guido233/HoloCubic/1.Hardware/RevB-KiCad/Naive/Closure/README.md

# 本轮问题闭合状态

本轮条件是**只有文件和图纸，没有样件、板厂订单或实测数据**。已经修订能由工程文件明确解决的问题；整机装配与运行尚未闭合，不发布制造放行结论。

| 问题 | 已落实的文件和检查 | 仍缺的证据 |
| --- | --- | --- |
| 六层叠层未选择 | 选定公开 JLC06101H-3313 模板，保存请求/响应；铜与介质 1.04mm、CAD 含阻焊预算 1.06mm；机械复核已更新 | 板厂对本工程的成品厚度口径、公差、孔分类及工艺回签 |
| 显示板阻焊制造间距 | 收紧 0.10mm 阻焊桥和 0.09mm 开口到异网铜；外扩改 +0.025mm，原 33 项错误归零，铜与锡膏未以放宽规则处理 | 制造/装配方接受实际工艺 |
| 屏幕尾排纵向落点不足 | 12 个 5.5×0.50mm 长焊接区、相邻器件重排、全板重新布线；144 项相关公差计算通过 | 允许折弯半径/区段、露铜面、横向注册、焊接工艺和实际屏体就座 |
| 长焊区锡量 | 删除 LCD 全长 F.Paste，明确 PCBA 回流后手工焊接，提供 1:1 接口参考图 | 供应商/装配方对手工焊温度、搭接和外观标准的认可及样件 |
| FFC 方向不明确 | 定义八根无交叉导体、两端同面露铜、Main n↔Ext 9−n 映射与端部公差 | 最终壳内路径、允许弯曲条件、长度/完整订货号与被动夹具实测 |
| 样机替代料与共料采购 | 2026-10-30 已应用 C24 / 显示板 C4 共用 GRM188R71E105KA12D、U6 用 TPS22918DBVT、主板 R3 用 RTT022000FTH；69 位号合并为 38 个 MPN 采购行 | 实际来料与装配验收、供电波形和功能测试；尚未实测或量产放行 |
| BH1750 上电复位验收 | 明确 M10 / C11.1、M11 / C24.1 测 VCC / DVI，规定阈值区间、冷启动、慢上电及快速重插残压记录 | 对实际 C24 批次测得 VCC≥2.4V 后 DVI≤0.4V 至少 1µs；不能由 ACK 或软件等待代替 |
| 首板无明确测试入口 | 独立诊断固件已编译和检查，15 个实际元件端子测量图、记录表和具体试验步骤已提供 | 烧录及全部实物测量；含 `bh1750_dvi_reset` 的 15 项记录均 NOT_TESTED |

## 当前可交付内容

- [显示接口修订、相关公差计算和 1:1 参考图](DISPLAY-INTERFACE.md)：最小纵向搭接 0.9611mm；0.75mm 为项目手焊阈值，未冒充屏厂规范。
- [叠层与 DFM 询价定义](STACKUP-SPEC.md)：保存公开模板选中行与来源 SHA，区分订单名义、铜介质总厚和 CAD 阻焊预算。
- [FFC 定制接口定义](FFC-CABLE-SPEC.md)：已有完整电气和端部要求；长度没有数据就保留未定，不用社区 60mm 或样品料号填空。
- [诊断固件与首板验证](BRINGUP.md)、[正反面测量图](probe-map.svg)、[真实测量记录表](measurement-record.csv)。

新修订的两板原生 ERC、所有严重级别 DRC、全网连通和原理图一致性检查通过。完整检查数、故障回归及源文件散列见 [冻结记录](../VALIDATION.md) 与 [机器可读记录](../validation-results.json)。这些记录只证明所列文件约束，不证明设备已通电运行。

本次替代保持电气网络、标称容量／电阻值和接口，不要求修改固件；电容耐压和 R3 尺寸公差等变化见 [BOM 审查](../BOM-review.md)。默认 BH1750 读取 / 自动调光尚未启用，未使用的 `Ambient` helper 也不能未经计时和读取检查修正直接集成；这些现有功能边界没有被“物料替代已应用”关闭。U6 为相同芯片的包装替代，商城库存及报价仅是 2026-10-30 快照，见 [采购说明](../PURCHASING.md)。

## 继续闭合所需的最小外部输入

1. **屏厂受控图纸**：确认当前具体屏批次的尾排展开/预折状态、触点金属面、12pin pitch/露铜尺寸公差、允许折弯位置/半径、COG/元件凸高、背胶及允许焊接条件。现有 11.10±0.5mm 裸屏背折图没有这些完整定义；不能靠选一个半径继续计算成已适配。
2. **装配注册**：明确显示板/屏体相对上壳的承托面、止挡和最终姿态。历史装配缓存约 22.39° 与上壳约 29.61° 的差异仍没有唯一注册证据。取得可信装配图或样件尺寸后，才能最终锁定 FFC 路径和长度。
3. **板厂回签**：接受指定模板、实际交付总厚范围、USB 内部孔到 land 距离、细线/孔环、ENIG、指定热孔处理及阻焊图。公开能力或模板不能代替本工程的 DFM 回复。
4. **一套实际样机**：完成供电及 BH1750 VCC/DVI 复位波形、USB、屏幕/背光、SD/WiFi、传感器、温升及最终闭壳 RF 验收。现阶段没有相应读数、波形或装配照片。

因此，本轮已完成明确的文件修复和验证准备；**不能仅靠继续修改文字或运行 DRC，把上述四项标成通过**。取得资料或实物结果后，应针对同一 PCB/固件 SHA 回填记录；如需改板或改壳，重新核对所有受影响的源散列和检查结果。
