guido233/HoloCubic/1.Hardware/RevB-KiCad/Naive/MECHANICAL-REVIEW.md

# Naive RevB 机械配准与装配验收

审查日期：2026-10-29。坐标单位为 mm，采用当前 KiCad PCB 的全局 XY，X 向右、Y 向下。原 Altium PCB、STEP 和历史接口基准保持不变。

**本版本尚不能释放生产。** 本轮已用图纸定义较长的P133H002手工焊接窗口，但实际尾排弯曲、板边绕行和上壳注册尚未通过实物验证。下列二维检查和局部实体检查没有替代整机装配验证；生产前仍需完成后述验收。

## 屏幕候选与电气条件

裸屏候选为 POLCD **P133H002**，不是带排针/稳压器的转接模块。[厂家产品页](https://www.polcd-digital.com/products/1-3-inch-tft-lcd-display-240x240-pixels-p133h002)与[厂家 13 页规格书](https://cdn.shopify.com/s/files/1/0657/1150/5511/files/P133H002.pdf?v=1779866387)给出：240×240、ST7789V、12 pin、0.7 mm 间距、26.16×29.22 mm 背光外形。p9 图注明外形 ±0.2 mm，厚度 1.46±0.05 mm **不含背胶和 FPC**；不能把约 1.5 mm 当成组装后的最大厚度。

引脚顺序与原屏接口一致：1 GND，2 LEDK，3 LEDA，4 VDD，5/6 GND，7 D/C，8 CS，9 SCL，10 SDA，11 RESET，12 GND。p7 背光总电流典型 30 mA、最大 40 mA，Vf 典型 2.8 V、最大 3.2 V，p9 为两颗并联 LED，未画内置限流。p9 的“40 mA, 3.0 V”不能替代 p7 电气表的限值；寿命章节的较大电流模板文字也不能作为允许电流。

RevB AL5802 + 27 Ω 的约 24 mA 是典型设计值。AL5802 的 0.65 V 调节值没有全温区电流精度保证，不能只叠加电阻 1% 就宣称最坏电流已受控。样件必须测电源范围、环境温度和稳态封壳下的电流与温升，背光电流不得超过屏厂 40 mA 最大值。

## P133H002 图纸注册与明确长焊接窗口

当前 ExtendBoard 板框为 X **133.8072..163.1950**、Y **91.8845..118.1227**，即 29.3878×26.2382；中心 **(148.5011,105.0036)**。原始 active stack 为约 1.0 mm 介质加两侧各 0.03556 mm 铜，合计 **1.071118 mm**，不应默认采购 1.6 mm PCB。

为说明配准，假设把 P133H002 的 26.16×29.22 mm 名义玻璃/背光外形中心与板框中心重合，且尾排从板右侧折回。则名义屏外形为：

- X **133.8911..163.1111**；Y **91.9236..118.0836**。
- p9 背视图局部坐标 u 横向 0..26.16、v 纵向 0..29.22 对应：**X=133.8911+v，Y=118.0836−u**。
- p9 展开图标出前视横向 10.30、到首触点 1.85、11 个 0.7 mm 间距。换到背视后，pin 1 的 u=26.16−(10.30+1.85+7.70)=**6.31**，pin 12 的 u=**14.01**。
- 因而该居中假设下，pin n 的 Y=**111.7736−0.7×(n−1)**；pin 1 在较大 Y，pin 12 在较小 Y，整排中心 Y=**107.9236**。
- 历史 legacy LCD1 的 pin n 为 **X=156.2100，Y=111.7219−0.7×(n−1)**，中心 Y=**107.8719**。横向 pin 排配准仅差 **0.0517 mm**，说明引脚方向可以一致；这不证明尾排的纵向位置可达。

p9 的裸屏背折示意标出屏尾根至折回接触端最外沿 **11.10±0.5 mm**，露铜长度 2.00 mm。按此图的名义平面折法，接触区中心距屏尾根约 10.10 mm，映射到 **X≈153.0111**。历史焊盘中心 X=156.2100，差 **3.1989 mm**。

本轮采用显式RevB长窗口修订：每个LCD1触点为F.Cu上的 **5.5×0.5mm** land，X范围 **152.25..157.75**、中心X=155.0，pin n的Y=**111.7736−0.7×(n−1)**，整排中心Y=**107.9236**。同时修正行位置0.0517mm并保持pin1在较大Y、pin12在较小Y；原四块Altium源及其旧焊盘基准不改。F.Mask外扩每边0.025mm，**无F.Paste**，定义为装配后手工焊接裸屏尾排，不作为整面印膏回流区。图纸约束与最小搭接计算见 [显示接口记录](Closure/DISPLAY-INTERFACE.md)。

这个窗口覆盖更多名义纵向落点，不能把X≈153.0111的裸屏背折中心冒充已经认证的整板焊接中心。厂图未放入额外PCB、实际板边绕行、弯曲半径、胶带/焊点高度或回环；仍须避免拉力、锐折和焊盘桥连。较长铜面是明确工程修改，不是POLCD厂家推荐land或实物装配通过证明。

该平面示意下，11.40mm尾端宽度映射约Y **102.2236..113.6236**；从接触最外沿到屏外侧0.8mm最小突出部分，约占X **152.0111..163.9111**。这里只作为图纸参考包络。为给长落点让位，CON1和内部器件已按下面记录重排、重布线；纸上窗口及DRC通过仍不认证完整FPC折弯路径。

## LCD 分面庭院建议及其边界

LCD1 的 parent footprint 在 B.Cu，但 12 个焊盘实际均在 **F.Cu**；这是尾排焊接面，不能由 parent layer 推断焊盘也在背面。旧 tft.step 同时包含屏本体和尾排，整体 bbox 不适合作为单独的B面屏体庭院；本轮已移除该误导性3D关联。

可以独立表达两项几何，禁止把它们当成已认证整机装配模型：

| 几何 | 全局 bbox [xmin,ymin,xmax,ymax] | 含义 |
| --- | --- | --- |
| 当前 F 面 12-pad 实际铜包络 | [152.2500,103.8236,157.7500,112.0236] | 明确5.5mm手工焊接窗口，无F.Paste |
| 当前 F 面 pad 包络外扩 0.25 | [152.0000,103.5736,158.0000,112.2736] | 实际pad-only F.CrtYd，未覆盖未知FPC路径 |
| 居中 P133 名义 B 面屏体 | [133.8911,91.9236,163.1111,118.0836] | 候选屏体，不含 FPC/背胶 |
| 候选屏体外扩 0.35 | [133.5411,91.5736,163.4611,118.4336] | 含尺寸半公差 0.10 与人为装配余量 0.25；不是供应商指定庭院 |

若添加候选屏体 B.CrtYd，应在 footprint/文档显式标注 **P133 candidate / unverified assembly**，避免日后把 courtyard DRC=0 误当成屏型号已适配。

## FFC 连接器与操作区

两板 CON1 指定 **Hirose FH12-8S-0.5SH(55)**，CL0586-0744-5-55：[厂家规格与图纸入口](https://www.hirose.com/en/product/p/CL0586-0744-5-55)。8 pin、0.5 mm、bottom contact、front flip ZIF、闭合高度 2 mm、适配 0.30±0.05 mm 端部总厚度的镀金 FFC/FPC。端部接触尺寸应按厂家 FH12 catalog 的 FFC 图生产，不凭“0.5mm 8P”商品标题判断。

使用 [KiCad 官方 FH12 8pin footprint](https://github.com/KiCad/kicad-footprints/blob/master/Connector_FFC-FPC.pretty/Hirose_FH12-8S-0.5SH_1x08-1MP_P0.50mm_Horizontal.kicad_mod)。原 Altium CON1 嵌入 STEP 自称 16-position AFFC20-16-050-SHB-T，不能用它识别真实 8pin MPN或证明装配。替换焊盘及 Main 的微移应作为明确 RevB 例外记录，历史基准不覆写。

KiCad 10.0.7 随包的正确 8pin STEP 有三个闭合实体，整体 8.1×6.4×2.0 mm；5.6 mm 的 Fab 主体深度不能代表包含引脚的全部实体。Main 原位置时，正确闭合体到 U4 最大尺寸 7.1×7.1×1.04 mm body box 最小距离 **0.4532 mm**、实体交集为 0；到 U4 顶侧 pad 包络只有 **0.3032 mm**。这解释了为什么整矩形 courtyard 报碰撞，却不能据此说实际闭合塑壳必撞。

尺寸依据 [Espressif ESP32-PICO Series v1.5 第55页图13](https://www.espressif.com/sites/default/files/documentation/esp32-pico_series_datasheet_en.pdf)：D/E 最大7.100、A最大1.040 mm；7×7×0.94 mm 是名义尺寸，旧1.0 mm高度不构成最大包络。按1.04 mm重算，原CON1位置的0.4532 mm距离与零交集结果保持；最终CON1上移0.30 mm后，闭合模型到最大PICO盒的最小距离约 **0.66749 mm**。同一主板名义B面座位和更新后的1.06 mm CAD总厚下，PICO最大盒与原Upper/Lower交集为0，到Upper最小约 **2.82916 mm**；另加0.08 mm假定焊后高度预算时约 **2.74916 mm**。这项额外预算不是芯片厂家尺寸。完整计算见 [PICO高度复核](Mechanical/PICO-max-body-screening.json)，不包含FFC开盖/排线扫掠。

给 PCB agent 的 shaped courtyard 为三个独立实体投影 bbox 与全部 signal/MP 焊盘包络分别外扩 0.25 mm 后取 union，保留全部实际几何。Main CON1 上移 0.30 mm 到 **(143.9545,104.7163)** 时，与原位 U4 的对应庭院间名义约 **0.1032 mm**；U4/RF 无需因此下移。0.25 mm 是明确的密集装配设计选择，不是 Hirose 官方推荐庭院；应重新运行所有邻件 DRC。

最终邻接 C6/C10 的密集装配规则还需区别于上述初始 0.25 mm 方案。对完整 FH12 STEP 实际网格投影复核，FFC 到两颗电容最大 body 的投影距离均约 **0.2705 mm**，到铜约 **0.2915 mm**；FFC 外扩 0.25 与电容外扩 0.10 的庭院仍会重叠，不能通过删去真实几何假装保留 0.25。本轮已批准双方各 **0.10 mm** 的明确 dense margin，名义间隔约 **0.0705 mm**；该余量需装配厂接受贴装/器件公差并实测。FFC 名义模型没有替代最大制造尺寸和操作空间验收。

上述只核**闭合状态**。开盖扫掠、手指操作、排线插拔/折弯尚无完整注册模型。Ext CON1本轮向左移2.9mm，当前origin **(146.9346,105.0417)、90°**；同一正确闭合体bbox随之为X144.9346..151.3346/Y100.9917..109.0917。插入口朝较大X，出线经过LCD尾排焊接区附近，仍需实测高度及操作顺序。不能仅以二维庭院未重叠声称可插拔。

FFC端部尺寸、同面露铜、无交叉导体及定制图要求见 [排线规格](Closure/FFC-CABLE-SPEC.md)。最终长度仍依赖无拉力装配路径；标准候选不能视为已锁采购兼容性。逐线通断确认Main pin n对应Ext pin (9−n)，特别是5V/3V3/GND，再上电。两端“Type A/同向”的销售术语不能替代电气连续性检查。

## USB1 采购闭环：GCT USB4105-GF-A

RevB 选定 **GCT USB4105-GF-A**，默认 0.95 mm 穿板 shell stake，16 个电气触点、USB2.0、Top Mount。[厂家现行产品页](https://gct.co/connector/usb4105)标记 Active；[厂家当前下载图纸](https://www.gct.co/files/drawings/usb4105.pdf)实读为 **B4，18/12/2023**。原 USB1 STEP 只写 User Library-USB - C v1，不能据几何相似认定原器件也是 GCT。

使用 KiCad 10.0.7 的 `Connector_USB:USB_C_Receptacle_GCT_USB4105-xx-A_16P_TopMnt_Horizontal` 与同名正确 STEP。目标 footprint **origin (160.06617,104.9909)、90°、F.Cu**，按原模型的插入口面 X=163.74117、中心 Y=104.9909 对齐；不能沿用原 footprint origin (158.5595,104.9909)。

| 项目 | 原无型号模型/焊盘 | GCT 目标 | 差异 |
| --- | --- | --- | --- |
| 插入口外轮廓宽 | 8.95 | 8.94 | −0.01 |
| 插入口外轮廓 Z | 0.10..3.26 | 0.15..3.31 | 整体 +0.05 |
| 插入口中心 Z | 1.68 | 1.73 | +0.05 |
| 信号焊盘排 X | 156.0395 | 156.38617 | +0.34667 |
| 两定位孔 X | 157.5795 | 157.46117 | −0.11833 |
| 两定位孔 Y | 102.1009 / 107.8809 | 相同 | 0 |
| 两定位孔 | 无铜环 pad0 被导入为 PTH | Ø0.65 NPTH | GCT B4 确认塑料柱 Ø0.50、推荐孔 Ø0.65 |
| 后侧两个 shell slot X | 157.0795 | 156.96117 | −0.11833 |
| 前侧两个 shell slot X | 161.0795 | 161.14117 | +0.06167 |
| shell slot Y | 100.6659 / 109.3159 | 100.6709 / 109.3109 | 各向中心 0.005 |
| 后侧 slot 钻槽 | 1.7×0.6 | 1.7×0.6 | 不变 |
| 前侧 slot 钻槽 | 1.2×0.6 | 1.4×0.6 | 长度 +0.2 |

16 个触点对应 12 个物理信号 land；四对 VBUS/GND 各共用 land。四个 shell 脚为 SH。全部 pad、孔、slot、姿态均用明确 `naive-revb` 目标 profile 检查；不再沿用先前无型号 USB 的单独 NPTH 属性例外。历史基准保持不变。

目标 STEP bbox 为 X155.96117..163.74117、Y100.5209..109.4609、Z−0.95..3.31。源模型 bbox 为 X155.99117..163.74117、Y100.5160..109.4660、Z−1.0..3.26；向板内的实体占位仅增加约 0.03 mm。

密集装配 courtyard 采用完整 STEP 投影 bbox 与全部 pad 包络各外扩 0.25 mm 后取 union，全局 bbox [155.56117,99.9209,163.99117,110.0609]，未省略实际 body 或 land。相对 U4 原 courtyard 最右 155.3975，横向余量约 0.16367 mm。此 0.25 mm 是明确工程余量选择；默认库的 0.5 mm 矩形会多占空角，不代表实体必撞。

该变更保持插入口 XY，**Z 增高 0.05 mm**。尚无完整外壳注册，不能宣称外壳 USB 孔已通过。须核图纸公差、焊接高度、实物插头胶壳及图中 1.85 mm 最小配合间隔；保持原 face XY 不是免验收条件。

## A1 采购闭环：CA-C03 与工程焊盘

RevB 明确选用 **CrossAir CA-C03**。[原厂下载页](https://www.gzhwjdz.com/DownLoad/45858.html)取得的 CA-C03_V02 规格书 p2：L=5.5±0.2、W=2.0±0.1、T=1.0±0.1 mm，端金属长度 a=0.5±0.1 mm；白色标志侧为馈电端，另一端仅用于焊接固定。pin 1 为 RF feed，pin 2 保持 **NC，不接地**。原 Rainsun 名称与旧 STEP 不是该采购型号的依据。

保持 body center **(143.5227,115.3541)、180°、F.Cu**，使用以下 **rect 工程 pad**：

| 端点 | X 范围 | Y 范围 | 中心 | 尺寸 |
| --- | --- | --- | --- | --- |
| NC 支撑 pin2 | 140.4200..141.5227 | 114.2541..116.4541 | (140.97135,115.3541) | 1.1027×2.20 |
| RF feed pin1 | 145.5227..146.8727 | 114.2541..116.4541 | (146.1977,115.3541) | 1.3500×2.20 |

这不是直接照抄 p4 的 1.2×2.0 mm 名义参考 land：NC 外侧 toe 为板边净距裁短，两端 inward heel 与高度加大。L 最小 5.3 且 a 最大 0.6 时，左端金属内缘达到 141.4727、右端内缘达到 145.5727；加上 ±0.05 mm 端点位置误差后，分别由 heel 141.5227、145.5227 完整覆盖。最大 body 左外缘加负向贴装误差为 140.6227，仍在 NC toe 140.4200 内侧，保留约 0.2027 mm 外侧铜余量。H=2.20 覆盖 W 最大 2.10 加两侧各 0.05 误差。该 **±0.05 mm 指每个金属端任一点的位置误差，包含旋转投影**，不能只验收器件中心 ±0.05 而允许额外转角误差。

按当前真实圆弧板框计算，NC pad 的最小板边距离约 **0.2592 mm**、feed 约 **0.2970 mm**。NC toe 若取 140.4000，其下角到圆弧只有约 0.2460 mm；因此最终采用 140.4200，不能仅按矩形边缘估算。曲线离散误差上限约 0.001 mm，最后仍应以 KiCad 原生铜到板边 DRC 和制板厂尺寸公差复核。

原 RF endpoint X=146.0627、Y=115.3541 落在新 feed pad 内，七段原 RF 走线可保持；这并不代表阻抗或谐振已通过。更大 land 会改变寄生参数，装配厂必须接受该工程 land 并验收端点覆盖。参考板的 3 nH 匹配不能照搬到本板，需按最终 PCB stack、空区、外壳与显示器装配完成 VNA 匹配及实际无线性能测试。历史 A1 基准保持 advisory，只有显式 `naive-revb` profile 锁定上述 CA-C03 几何。

原 RAINSUN `123.stp` 不再用于表示 CA-C03。没有取得原厂精确 STEP 时，使用明确命名为 **Bounding Envelope** 的 5.7×2.1×1.1 mm 最大 body 包络，局部 XY 以器件中心为零、Z=0 为板面。该模型省略金属端缺口、标志和内部结构，只是保守占位示意，不是厂家精确模型，也不构成装配或 RF 验证。

## J1 采购闭环：Molex 104031-0811

RevB 选定 **Molex 104031-0811 / 1040310811**。[厂家产品页](https://www.molex.com/en-us/products/part-detail/1040310811)在浏览器实际渲染中显示 **Active**；静态网页抽取混入的隐藏“limited information”模板不能用来判定停产。[原厂正式图 SD-104031-001 B2](https://www.molex.com/content/dam/molex/molex-dot-com/products/automated/en-us/salesdrawingpdf/104/104031/1040310811_sd.pdf)与[产品规格 PS-104031-001](https://www.molex.com/content/dam/molex/molex-dot-com/products/automated/en-us/productspecificationpdf/104/104031/PS-104031-001-001.pdf)确认 push-pull、前方插入、8 个卡触点、独立常开检测开关、四个 shell solder lands、1.10 mm pitch、0.5 A/10 V。

本体名义 11.95×11.40×1.42 mm，比先前评估的 14.4×15.2 mm Amphenol GTFP08431BEU 更接近源卡座模型的约 12×11.5 mm。GTFP 大件未用于 RevB；其官网链接的 STEP 内部还标成 HR 变型，不能作为 BEU 精确模型认证。源 Micro_SD 模型同样没有确证 MPN，不把 Molex 冒充原有器件。

原模型 socket 口位 X=145.61914、完全插入卡外端 X=140.48164、卡中心轴 Y=105.4062。Molex 正式图的完全插入卡外露量为 4.0 mm，源模型约 5.1375 mm。最终为避开 USB 的贯穿固定脚及其双面焊锡铜环，采用 **origin (149.53164,105.3112)、270°、B.Cu**：

- 保留卡中心轴 **Y105.4062**；完全插入卡外端改为 **X139.83164**，比旧端左移 **0.65 mm**，不是完全保持旧端。
- 新 socket 口为 **X143.83164**，比源 socket 左移 **1.7875 mm**。
- 只保持源 socket 口时，与 USB 名义实体间距仅 0.02625 mm，等效板厚 0.9 mm 情景会交叠，因此不可用。
- 先前“完全保持卡外端”的中间位置虽有约 0.8141 mm 体距，却让 Molex 后 SH 的 B 面 copper land 与 USB 贯穿铜环实际投影重叠约 **0.2171 mm²**；同属 GND 不会产生异网短路告警，但不能作为装配通过。最终额外左移 0.65 mm 消除这一重叠。

使用完整官方 STEP 的 XY 网格投影、全部真实厂家 lands 取 union 后外扩至少 **0.25 mm**，保留全部物理几何。实际构造用 0.255 mm offset，网格弦误差 0.002 mm、轮廓简化误差 0.001 mm，以免误差吞掉所需余量。最终 shaped courtyard 有 67 个点；新 land 到 USB 贯穿铜环最小约 **0.32953 mm**，庭院到铜环约 **0.07453 mm**，所有孔/铜投影交集为 0。这是密集装配的明确工程规则，不是裁掉真几何以消除 DRC。

“等效板厚”只是 USB stake 长度/板厚风险的几何情景，不能代替真实公差分析；最终仍以所购板厚、stake 尺寸和焊接高度验收。

**正确姿态是官方 footprint 经 KiCad 原生 Flip 到 B.Cu 后设 270°。** 90° 会让卡口朝相反方向。原生 SaveBoard→LoadBoard 与全部 pad 坐标已验证：

- pin n=1..8：X=**144.08164**，Y=**102.2062+1.10×(n−1)**。
- 检测端 9=(150.23164,99.5712)，10=(153.93164,99.5712)，是独立两端常开开关；未用时按原理图明确处理，不把它们认成信号 9/10。
- SH 四个中心：(144.20664,99.7462)、(154.90664,103.0712)、(154.90664,109.0412)、(144.43164,111.0662)，全部接 GND。
- KiCad stock 的 pad8 把厂家外侧 land 裁短 0.10 mm，宽为 0.75、local X=4.545。RevB 按厂家图恢复 **0.85×1.10、local X=4.595**（翻面前的厂家坐标），保持 7×1.10=7.70 总 pitch；恢复后到 SH2 铜间距约 0.15 mm，需以本板规则和装配要求复核，不能误称 stock 与厂图完全一样。

官方产品页取得的 STEP AP242 附属 TXT 明确 REFERENCE=1040310811、SUPPLIER=Molex。模型仅做刚性坐标注册后使用，未重画或删除实体；保留原始 STEP 和转换矩阵。其卡片高度必须另读正式图：**下表面 (0.62±0.20)、上表面 (1.57±0.20) mm**，而非把 socket 的 1.42 mm 当成整个卡片装配高度。

这使源卡下方电阻列不可继续沿用。Yageo [现行 RC_L 原厂规格 V14 第 4 页](https://www.yageogroup.com/content/datasheet/asset/file/PYU-RC_GROUP_51_ROHS_L)给出 RC0402 为 1.00±0.05 × 0.50±0.05 × **0.35±0.05 mm**；0.35 不是最大高度。卡底最低参考值 0.42 mm 对 0.40 mm 最大器件高度几乎没有焊后余量。

最终17颗B电阻中，**16颗保留上部两排9+7**，R16移到下部独立位置；旧密集4×4槽及上排R16旧槽不保留。下表16颗为B面0°：

| X | y94.8 | y97.2 |
| --- | --- | --- |
| 141.7 | R4 | R1 |
| 143.7 | R5 | R13 |
| 145.7 | R12 | R18 |
| 147.7 | R7 | |
| 149.7 | R8 | R17 |
| 151.7 | R9 | R14 |
| 153.7 | R10 | R15 |
| 155.7 | R19 | R11 |
| 157.7 | R20 | |

C16 为 GRM1555C1H101JA01D（100pF / C0G / 50V / ±5%），中心 **(159.3,115.1)**、B 面、180°，厂家最大高度 0.55 mm。此型号替代早期 1nF 定时电容，并由旧上部 B 面区域移到 U6 旁；CT 铜长约 1.369 mm。外形预算不变。布尔验证按电阻最大外形 **1.05×0.55×0.40** 加 **0.08 mm 假定焊后 stand-off**，即总占位高度 **0.48 mm**；C16 最大 body **1.05×0.55×0.55** 加同样预算，合计 **0.63 mm**。0.08 是工程预算，仍需贴片工艺确认。

已对最终 Molex 配准、实际 GCT STEP 的较长固定脚/0.85 mm 等效板厚情景、卡底 0.42 至顶面 1.77 mm 包络及沿 X 抽出扫掠重新计算，18 个器件盒与这些实体交集均为 0；最终局部 CT 位置复核的最小距离为 **Molex→R16 0.8238 mm、USB→R11 3.06753 mm、卡/扫掠→R16 1.2188 mm**。PCB 上所有这些器件的庭院还须经过原生 DRC；二维无交叠不替代壳体高度检查。这只证明局部 connector/card 关系；下壳承托平台必须另作注册检查，不能由这些距离推出壳体适配。

产品规格 §7.1 建议提供防掉卡挡盖/锁卡结构，并使卡与挡盖间隙不大于 0.25 mm。Naive 旧外壳是否能提供该约束尚未验证；无实体相交不是抗冲击掉卡测试通过。最终须用所购 microSD、完整插拔和闭壳样件确定开口、接触、取卡及保卡性能。

## R16下部移位与RF投影复核

R16保留原10kΩ/0402/完整MPN和电气连接，最终为 **(144.3,112.4)、180°、B.Cu**：pin1接原**3V3**，pin2接**SD_DAT1**。它不接3V3A。SD_DAT1用B面短线接J1.8；3V3用B面支线及(142.475,111.925)的0.46/0.25mm过孔接现有In2铜岛。上部只删除原R16独占的两段3V3叶枝，公共总线三岔节点(147.8458,95.4538)及其它电阻供电保持。新DTR局部过孔/短线按原生DRC重新避让，其整网连续性恢复。

按1.05×0.55×0.40mm最大body加0.08mm假定焊后高度，R16总包络1.05×0.55×0.48mm。对实际Molex、卡片插入/抽出扫掠、USB及Upper均无交集；Molex/卡片最小体距为0.8238/1.2188mm。它与原Lower仍有约0.003598mm³交集，因此最终新下壳增加该处浅槽并移除旧上排槽，不能直接沿用旧壳。

即使原B面规则只禁铺铜，也把原Top/Bottom天线区和RF feed corridor的投影作为新R16铜的禁入区。最大body、两pad、新SD_DAT1铜、新3V3铜与该投影交集均为0，最小距离分别为 **0.3931 / 0.3481 / 0.6161 / 0.0911mm**；最后一项来自3V3支线，须明确保留，不能四舍五入成更大的设计余量。该支线到CA-C03最大body投影约1.3271mm、到完整端金属铜约1.9115mm、到原7段feed铜约2.9675mm。原7段RF几何不变；这些是几何距离，不能据此认定天线匹配、效率或最终壳体RF合格。必须在实际天线、PCB层叠、排线、屏幕和闭壳状态下做VNA及无线性能样机验收。完整最终源证据见 [R16移位筛查](Mechanical/R16-relocation-screening.json)。

## C17 正面局部移位

最终C17为 **(155.88,111.02)、90°、F.Cu**，释放 GPIO13 附近空间。按 package 最大 **1.05×0.55×0.55 mm** 加0.08 mm假定焊后高度，旋转后的全局包络为0.55×1.05×0.63 mm。对实际GCT闭合STEP、实际Molex配准和同一主板名义壳体座位计算，交集均为0；到USB、Molex、原Lower、Upper的最小体距分别约 **1.06536 / 1.24218 / 1.54416 / 3.23916 mm**。详见 [C17移位复核](Mechanical/C17-pose-screening.json)。

C17 位于F面，且与原Lower已无交集；既有22个B器件/USB穿板脚减材槽无需因此变化。0.08 mm仍是工艺预算，USB模型是闭合名义实体，不能代替器件/贴装公差、FFC操作和实物就座。对应placement profile已启用，几何记录已按最终主板重新计算并记录最终source SHA。

## 历史底面 0402 与旧 TF/卡模型检查

以下是针对**旧模型、旧位置**的历史局部检查，不作为新 Molex 卡座下方布件的依据；这些左列器件在新布局中改放上述 B 面上方空带。

使用原 PCB 嵌入的 3.stp（包含卡座与已插入 microSD 卡），对新增低矮电阻按 1.0×0.5×0.35 mm 保守盒做 OpenCascade 实体布尔及最小距：

- x143.2941，y102.93/103.82/104.71/105.60/106.49/107.38/108.27/109.16：交集均 0，最小距均约 **0.3625 mm**。
- x159.2，y100.5/101.5/102.5/103.5/104.5：交集均 0，最小距约 **1.6178..1.6935 mm**。

这些结果只证明所用 TF/卡模型与候选电阻盒的局部静态关系。底壳尚未与 PCB 做可靠注册，未核局部筋、板支撑、焊膏高度、公差或卡插拔轨迹；不能把结果当成外壳适配认证。B 面不得据此新增更高的器件。

## U4 热焊盘的明确修订

`naive-revb` 额外锁定 U4 原姿态、48 个原信号铜 land，以及 [Espressif ESP32-PICO-D4 v1.5 图 16/17](https://www.espressif.com/sites/default/files/documentation/esp32-pico-d4_datasheet_en.pdf)所依据的显式热区修订：EP 铜为 **4.5×4.5 mm**、mask margin **−0.25 mm**，得到 **4.0×4.0 mm** 开窗；pin1 角为 0.5 mm chamfer。EP 不再带整块 F.Paste，改为局部中心 ±1.575/±0.525 的 **16 个 0.75×0.75 mm paste-only pad**。

热区采用 **21 个 Ø0.46/孔 Ø0.25 mm** locked GND 通孔，5×5 格点 {−2,−1.05,0,1.05,2} 去四角，F/B tenting 标志均启用。该前面 tenting 标志不意味着 EP 的大开窗内一定能封住孔；须由制造/装配厂确认塞孔/盖油和焊膏吸锡控制。48 个 perimeter pad 的 +0.025 mm mask margin 是明确的 RevB 制造选择，不改铜和姿态。

机械检查器检查信号 land、EP 铜/层/mask/chamfer、16 个窗口及 21 个孔的尺寸/位置/层/网络/锁定/tenting，不以忽略 U4 避开基准差异。原四板历史基准及其 source SHA 保持不变。测试已验证旧尺寸 EP、整块 paste、缺失 chamfer、错误窗口、孔径/网络/tenting 和移动信号 pad 均被拒绝。此几何检查不替代回流工艺和温升验证。

## 当前 Ext 11 件静态检查

本轮最终显示板源SHA为`7ba3a6e58040c57fe67f55df174be974967f560e97ab8b37d000d93db8e1c112`，仍为11个器件、外板框不变。所有新位置与LCD长焊盘均在显式`naive-revb` Ext profile中记录；历史Altium不被覆写。原生全项DRC、未连通和原理图一致性结果由独立电气验证记录，不以此处二维配置替代。

| 器件 | 当前全局中心X/Y | KiCad角度/面 |
| --- | --- | --- |
| LCD1 | 150.9522 / 104.5591 | −90° / B（pads在F） |
| CON1 | 146.9346 / 105.0417 | 90° / F |
| C1 | 142.8 / 107.2 | 0° / F |
| C2 | 141.5 / 105.5 | 0° / F |
| C3 | 138.5 / 108.5 | 0° / F |
| C4 | 138.2 / 106.5 | 0° / F |
| Q1 | 150.0952 / 112.9665 | −90° / F |
| R1 | 147.6822 / 112.6871 | 90° / F |
| R2 | 144.5 / 115.1 | 90° / F |
| R3 | 147.2 / 115.0 | 0° / F |
| U1 | 141.0 / 112.2 | 0° / F |

LCD1为B面parent、F面焊接触点，不能按parent猜焊接面。F面长窗口庭院与候选B面屏体庭院分开，`MechanicalStatus`仍标记装配未验证。新profile负例拒绝旧2.032mm焊盘窗口、旧CON1位置、恢复LCD印膏层和LCD阻焊外扩回到0.05mm；其余F件位置也被锁定。新版庭院间距及原生结果见 [显示接口记录](Closure/DISPLAY-INTERFACE.md)。内部器件重排不提供上壳或排线的唯一刚体注册，完整高度和操作验收仍按后文边界执行。

Q1 已改为 **AO3400A N-MOS，pin1 G / pin2 S / pin3 D**，避免 NPN 基极网络加载 GPIO5 启动 strap。AOS [产品页](https://www.aosmd.com/products/mosfets/low-voltage-mosfets-12v-30v/ao3400a)链接的 [SOT23 正式图 PO-00001N](https://www.aosmd.com/sites/default/files/res/package/SOT23.pdf)给出总高 **1.25 mm MAX**，不能套用其他厂商 SOT23 的 1.12 mm。body D 2.8..3.1、E1 1.4..1.8、lead span E 2.6..3.0，推荐 land 为 0.8×0.8 mm、两列中心 2.4 mm、同列 pitch 0.95 mm。已独立实读 `SOT23_NMOS` 三个焊盘：local 1(−1.2,−0.95)、2(−1.2,+0.95)、3(+1.2,0)，尺寸均 0.8×0.8 mm，符合该推荐图；不是沿用 Diodes NPN 的焊盘。

AL5802 SOT26 最大总高度约 1.4 mm；AO3400A 1.25 mm；Hirose 2 mm；新增电容/电阻实际高度需依最终 BOM 封装型号确认。屏背胶/FPC/焊点的 0.45 mm MAX 局部高度不能自动视为整机余量。没有可靠板间距、外壳注册与开盖模型，因此没有完成封壳实体布尔或整机高度认证。

## Main六层工程叠层与检查规则

最终Main选择 **F.Cu / In1.Cu / In2.Cu / In3.Cu / In4.Cu / B.Cu**，选用公开 **JLC06101H-3313** 模板，CAD含双面各0.01mm阻焊预算的总厚为 **1.06mm**。自上而下mm：mask0.010 / F铜0.035 / prepreg0.0994 / In1铜0.0152 / core0.250 / In2铜0.0152 / prepreg0.2104 / In3铜0.0152 / core0.250 / In4铜0.0152 / prepreg0.0994 / B铜0.035 / mask0.010。

[制造叠层记录](Closure/STACKUP-SPEC.md)保存官方公开接口、选中模板和原始响应：铜与介质合计1.04mm，双面阻焊各0.01mm为CAD工程预算。**订单名义1.0mm、模板compressionThickness=1.04mm、CAD1.06mm口径不同**，不能互相替代。Dk采用官方设计值3313=4.1、7628=4.4、core=4.6；未取得批次/频率/Df或本订单回签，不据此宣称控阻抗/RF合格。实际下单仍需板厂确认材料、成品厚度范围、阻焊及装配工艺。

In1和In4为专用GND，In2混合3V3/其它电源与信号，In3为信号和GND铺铜。三条原天线/馈线keepout完整扩展至全部四个内层，tracks/vias/pads/copperpour均禁用，外层原7段RF保持。`naive-revb` profile核层序、逐层厚度、In1/In4整板GND zone意图及禁止异网走线/铜区，并以0.001mm几何容差区分三条相近keepout；同时锁定16颗上部B电阻、下部R16/C16、C17及已批准内部器件位置。

本次仅中央prepreg从0.1696改为0.2104mm、CAD总厚从1.0192改为1.06mm，增加0.0408mm；材料/Dk元数据同步公开模板。已逐项比较58封装、1033直线、4弧线、145过孔、32铜区及板框图形AST，全部相同。B面承托不变，F面PICO/L1/C17/USB与闭合FFC相对壳体整体上移0.0408mm；PICO/L1/C17按新总厚直接重算，B面R16及RF的XY距离用不变几何证明转移。下壳仍从原Lower重建，22包络、切削参数和STEP DATA与旧版相同，仅报告与STEP头更新。

历史四块Altium的两层源、SHA和几何均未改写；显示板保留两层。六层负例覆盖回退两/四层、core/总厚错误、keepout删除/放松、缺任一专用地平面、在In1/In4走异网信号及旧R16位置，均应被拒绝。整体旋转37°仍通过。几何profile不替代原生重铺铜/孤岛/网络连续性检查、实际制造叠层确认和RF实测。

## 原 Naive 下壳注册与 RevB 内侧避让

已读取原 `4.3D Model/Naive Version/Lower.step` / `Upper.step`，不是按外包围盒居中。主板有独特非矩形舌部和多个不同半径的圆角，下壳对应凹口可提供名义注册：

- 下壳长侧壁 case X=+11.7475003745 / −11.7474998687 分别对应 PCB Y116.7511 / 93.2561。
- 舌端 case Y=−12.0680578747 与 USB 侧板端 case Y=16.4309426150，独立对应 PCB X134.2517 / 162.7505。采用平均平移，两端残差约 ±0.0001003 mm。
- 独特圆角半径 0.43360565 / 0.82794711 与对应板框约 0.433629 / 0.827940 及周边平面一致；USB mating face 映射到 case Y17.421512，也与壳内端面约 17.42094 对应。

以 PCB 全局 XY 和 **Z 向 B 面外侧**为输入，名义变换为：

```text
case X = PCB Y − 105.0035997471
case Y = PCB X − 146.3196576298
case Z = 3.0708410413 − Z
```

Z=3.0708410413 是与该非矩形 PCB 凹口相连的水平承托平台。这里明确假定 PCB B 面在该平台就座，而不是从同中心或 MCU 高度猜测。该**名义承托注册仍需实物确认**；PCB 翘曲、打印收缩、承托间隙和固定预载尚未测量。源 MbaDoc 没有壳体或 mate，不能宣称存在原作者显式整机定位约束。

同一注册下，原壳与16颗上部电阻高度预算盒分别交叠约0.2772mm³，新R16约0.003598mm³，最终局部C16约0.363825mm³，说明新增 B 面器件不能直接配旧下壳。Molex、插入卡包络、GCT、Main 的闭合 FH12 及电感保守盒与原上下壳局部交集均为 0；这不覆盖显示板和排线操作。L1 厂家最大package为 **3.1×3.1×1.2 mm**；这里采用的 **3.4×3.1×1.28 mm** 盒在X另留0.30 mm、在高度另计0.08 mm假定焊后预算，是额外工程筛查包络，不是厂家标称body。以当前L1中心(146.25,95.95)、1.06 mm CAD主板总厚重新计算，厂家最大盒和该额外包络到Upper最小距离分别约 **2.66916/2.58916 mm**，与原上下壳交集均为0。

因此新增 [Lower-RevB.step](Mechanical/Lower-RevB.step)，只对下壳内侧减材，原 Lower.step SHA256 为 `23b730990a614816d785743643510fa44fa6864c99214521034c588333707fc2`，原壳文件不改。避让槽先取**最大 body 与当前焊盘落锡包络的 union**，再加 XY 各 0.25 mm、Z 0.15 mm；不会只给塑壳让位而压住向外伸出的焊盘焊锡。电阻槽深 0.63 mm，最终 (159.3,115.1) 的 C16 槽深 0.78 mm；不保留旧 (149.22,98.04) 的槽；另有下述 USB SH 内侧浅槽。板的承托高度、外轮廓、USB 孔和螺柱保持。

[机器验证记录](Mechanical/Lower-RevB-verification.json)保存原 CAD SHA、OCP 版本、脚本/参数 SHA、输入/输出体积与 bbox、solid/valid 和 STEP 重读结果。18 个器件及 4 个 USB 穿板/落锡包络与输出 STEP 的交集均为 0，最小实体距离约 **0.1500 mm**。新增槽底至外底至少 **2.29084 mm**、新槽到外侧壁至少 **2.72640 mm**、到四个 Ø4 紧固沉孔的 R2 保留区至少 **1.00966 mm**（最近处是局部 C16 槽）。R2按模型最大的Ø4沉孔包络取保护区，不是由模型认证另一种螺柱外径。原 TF 凹腔已有的 **1.0 mm** 底壁不变；2.29084 不是全壳最薄处的宣称。

输出仍为一个 valid solid，外 bbox 不变；STEP 重读仅有约 0.000280 mm³ 的体积数值差（小于 1 ppm），并重新检查 bbox 与所有器件间距。该微小差异作为 STEP 数值容差记录，不以体积相近替代实体距离检查。

可在独立 Python 3.11+ 虚拟环境安装 `cadquery-ocp==8.0.1.1.0`，在仓库根运行：

```sh
python tools/hardware/revb_case.py --output /tmp/Naive-RevB-Mechanical
```

输出目录必须不存在。脚本核原壳 SHA、当前 Main 接口/热区 profile、18 个器件位置、实际焊盘包络及 4 个 USB SH 位置后重新减材；尺寸或位置变化会停止，不能自动把未审的新布局当成已验证。

卡片完全插入时不碰壳，但往外抽出的扫掠与旧下壳前墙相交。此壳没有可供该轨迹通过的外部 SD slot，因此**必须拆下壳换卡**；RevB 仅增加内部浅槽，没有承诺闭壳取卡。需要外部换卡时，须另行设计壳口和保卡结构。

## USB 对成品板厚的敏感性与穿板脚避让

GCT B4 图给出默认 stake **S=0.95±0.15 mm**，不是精确 0.95。成品板厚 0.90 mm、最大 stake 1.10 mm 时，金属最多可伸出 B 面约 **0.20 mm**；先前只用名义 0.95 与等效 0.85 板的场景只覆盖约 0.10 mm 穿出量。

对成品厚 **0.90 / 1.00 / 1.09112 / 1.10 mm**、0 / 0.08 mm 假定焊接 stand-off、整个 USB 模型 Z 偏移 −0.15 / 0 / +0.15 mm 作 **24 个离散情景**筛查。整模偏移只是保守筛查手段，不是每个表面独立公差的严格 GD&T 模型。Molex 与 USB 全部交集为0、最小体距约 **1.10504 mm**；上壳全部交集为0、最小体距约 **0.28916 mm**。

较薄板场景中，GCT 前侧两根 stake 会穿入原承托平台。最坏相交仅位于 case X[−4.4827,−4.1827]/[4.1573,4.4573]、Y14.5060..15.1370、Z2.87084..3.07084；没有因此要求移动外部 USB 开口。

最终下壳对四个 SH 位置统一按**整片铜环/slot 投影外加0.25 mm**开内部避让：0.20 mm 金属穿出 + **0.15 mm 假定焊锡高度预算** + 0.15 mm Z 净空，槽深 **0.50 mm**。前两槽实际减材，后两处原 TF 低腔已提供空间。此处焊锡预算与 SMD 的0.08 mm stand-off预算用途不同，均须由装配工艺确认。新槽底2.57084 mm仍高于 C16 避让槽底2.29084 mm，不改变总体最小新槽底预算。

[厚度筛查记录](Mechanical/USB-thickness-screening.json)保留24个参数情景的既有直接CAD结果，并用最终R16变更的材料集合证明转移至当前STEP：其它21个cut box和原Lower完全相同，新增回填材料仅可能位于旧R16顶槽（globalY≤97.77），USB的globalY≥100.5209，间隔至少2.7509mm；新增R16下槽是减材，其区域又与USB在X上至少相隔10.63117mm。两处均远于旧情景的最近距离，故全部交集与最小距保持。最终STEP先前直接复核的最薄/旧名义1.0192/最高三项仍按原参数保留，均为0交集；下壳距离约0.20857/0.47777/0.50490mm。另新增当前**1.06mm**下0/0.08mm焊后预算、−0.15/0/+0.15mm整模Z偏移的6项直接检查；所有上下壳/Molex交集为0。当前1.06、零额外偏移场景下，下壳/Upper/Molex最小距为0.50490/0.55916/1.35345mm。旧24项及旧名义没有被改名成新厚度。该转移证明没有冒充24次新的直接运算，也没有把离散筛查称为完整GD&T或插头胶壳认证。原承托名义Z、实际成品板厚、焊锡堆高和插头胶壳仍须样件验收。

## 显示板与上壳尚未建立唯一注册

重新解包原 MbaDoc 只有两块 PCB 缓存，`MatingPairs=[]`，没有壳体。缓存 ExtendBoard 相对主板倾斜约 **22.39281°**，而 Upper.step 最大倾斜平面约 **29.61254°**，相差约 7.22°；不能直接拿缓存变换给上壳配准。

上壳该倾斜面的外矩形约 27×30 mm，显示板外形 26.2382×29.3878 mm 仅提示几何相近。居中后约 0.3809/0.3061 mm 的余量不能选定真实承托面、沿斜面平移、板的正反面或槽内高度。显示板无定位孔，也未找到能独立确定这些自由度的匹配阶差/止挡组合；用任意居中变换做布尔会给出不可靠的“通过”。

该斜面的一个参数化候选可写为：令 u=PCB_X−148.5011、v=PCB_Y−105.0036，则 C=(0,3.652841,26.664389)+v·(1,0,0)+u·(0,0.86938681,−0.49413214)+δ·(0,−0.49413214,−0.86938681)。其中 δ 是未定承托偏移，还存在沿面平移及 u/v 反向的选择；此式仅表达现有面法向约束，没有被用作通过判断。

因此尚未给 Ext 的 FH12、SOT26、AO3400A、候选 LCD/FPC 以及两板间排线出具上壳配合认证。需实测显示板承托面/止挡、板间高度、屏背胶与 FPC 绕行后，记录其刚体变换再补完整检查。新增下壳的主板局部通过不能替代这一门槛。

## 外购物料与紧固件的证据边界

原作者 README 指定一个 **25.4×25.4×25.4 mm 分光立方体**及少量 **OCA 固态光学胶膜**。作者在 [issue58](https://github.com/peng-zhihui/HoloCubic/issues/58#issuecomment-980536929)澄清购买的是分光棱镜；没有给出确切镀膜、分光比、NPBS/PBS、玻璃或完整光学料号。1:1 商品描述来自社区回复，不应改写成作者指定规格。OCA 厚度也未锁，须连同屏/FPC 样件确定；先测试偏振方向和成像，再固定。

上下壳使用原 Upper.step 与新增 Lower-RevB.step。四个螺钉轴中心在 case (±9,−9)、(±10,17)。下壳有 **Ø4 mm、深3 mm** 的沉孔和 **Ø2.5 mm、长5 mm** 的通孔；上壳为 **Ø1.5 mm、深5 mm** 的盲孔。模型可证明数量为4和上述孔尺寸，未定义螺纹。

头径小于4 mm、头高小于3 mm、头下长约8 mm 的 M2 级螺钉可作为试装候选：穿下壳5 mm后在上壳啮入约3 mm。但 Ø1.5 盲孔不能单独确证标准机牙或自攻牙，完整牙型/长度必须由打印或加工方按材料和试装锁定。该候选不作为已经验证的最终紧固件 MPN；也不据此盲拧树脂件。

## 释放生产前必须完成的样件验收

1. 供应商确认 P133H002 的确切图纸版本、供货时尾排展开/预折状态、接触露铜面、允许折弯位置/半径，以及两颗 LED 的总电流上限；取得同批裸屏样件。
2. 用最终 1.0 mm finished-thickness 约定的 PCB/等厚机械样片、实际屏/背胶和外壳，确定无拉力、无锐折的尾排绕行路径。测量 12 个触点对当前焊盘的真实注册，确认最小焊接重叠、无桥连、无板边切割 FPC。若不能满足，修订 LCD 焊盘和周围器件，更新明确机械 profile，再重做电气/DRC 检查。
3. 核实 FH12 开盖、插入、锁闭和更换均可操作；排线接触面/端厚/宽度符合官方图，安装后没有压迫屏尾排、器件或壳筋。固定电缆两端后仍留有余量，通断和电源映射正确。
4. USB1 已锁 GCT USB4105-GF-A，按前述新 footprint 与官方图核实定位孔、插入口高度和实物插头操作；A1 已锁 CA-C03 并须验收上述工程 land；J1 已锁 Molex 104031-0811，验证完全插入卡的位置、整个插拔轨迹和挡盖/保卡约束。
5. 装入 microSD 并核其拔插；使用新增 RevB 下壳，实测主板在承托面就座及 17 颗 B 面电阻、C16 的避让，包含上述 0.48/0.63 mm 焊后高度预算；核 2 mm FFC、1.4 mm SOT26、最高电容/电感与上部件高度。
6. 完整闭合外壳，测试屏幕刷新、背光最坏电流/稳态温升、USB 接口和无线连接。CA-C03 需核净空、匹配并实测，已锁型号不等于匹配完成。最后重跑原理图一致性、铜皮重铺、ERC/DRC及机械接口检查，保存验收证据。

局部 CAD 结果与样件验收应分别记录。尚无某项检查的结果时，不以“DRC 全零”或旧 3D 模型代替该项通过结论。

## 2026-10-30 物料替代的适用性

本轮应用主板 C24、扩展板 C4、U6 和主板 R3 的新料号，完整原厂身份及替代前后文件 SHA 见 [物料变更记录](component-substitutions.json)。两板全部非物料字段的原生结构、网络、布线、焊盘、位姿、层叠及模型逐项保持。两处电容的最大本体均保持 0.9mm，U6 为相同 DBV6；R3 候选最大 1.10×0.55×0.35mm，在原庭院内，现有密集 land 的贴装工艺仍需首板确认。

本目录五份 Mechanical JSON 保留原数值计算和原始输入散列，新增 component_substitution_transfer 指向当前 PCB 与本次几何保持证据，没有把原计算改写成新 STEP 布尔计算或实物试装。本轮板框/孔/接口修订检查重新通过；完整显示装配、屏幕尾排和壳体公差的实物验收条件保持。
