guido233/HoloCubic/1.Hardware/RevB-KiCad/Naive/Closure/DISPLAY-INTERFACE.md

# 显示屏纵向焊接落点修订

本次实际修改显示板，关闭的是**接触端沿 X 方向的落点范围不足**。P133H002 尾排的允许弯折半径、露铜面、横向注册及完整装配仍待供应商或样品确认，不能把本项计算改写为整机已适配。

## 原厂尺寸与计算边界

依据 [POLCD P133H002 原厂规格书](https://cdn.shopify.com/s/files/1/0657/1150/5511/files/P133H002.pdf?v=1779866387) 第 9 页 Rev A 机械图（图页标注 2021.10.7，原始图日期 2020.09.10）：屏体长 29.22±0.2mm；裸屏背折示意的 11.10±0.5mm 是尾根到**露铜端外沿**，并非接触中心。露铜长度 2.00mm 采用图中 NOTE9 未注尺寸 ±0.2mm。FPC 以展开状态出货；图未给允许折弯半径或区段。

名义屏体与 PCB 中心重合时，尾根 X=163.1111mm。计入居中屏体半长偏差后，尾根范围为 [163.0111,163.2111]mm。令尾根为 R，背折外沿尺寸为 D，露铜长度为 L，则露铜区间为 **[R−D, R−D+L]**。这些相关量一起枚举，不能先给接触中心一个 ±0.5mm，再把露铜长度独立固定为 2mm。

## 已实施的工程变更

- 12 个 F 面焊盘改为 **5.5×0.50mm、0.70mm 间距**；X 区间统一为 **[152.25,157.75]mm**，pin n 的 Y=111.7736−0.7×(n−1)mm。引脚功能、顺序及电源映射不变。
- F 面焊接庭院完整包络 [152.0,103.5736,158.0,112.2736]mm，包含每侧 0.25mm 余量。B 面候选屏体庭院保留，仍不代表完整尾排几何。
- 为让开真实铜和庭院，调整 CON1、Q1、R1、C1、R2、R3 并重新布线；没有裁掉相邻器件真实庭院。显示板板框保持不变。
- 所有 SMD 阻焊扩张改为 +0.025mm，项目检查绿色阻焊桥至少 0.10mm、开窗到异网铜至少 0.09mm。新 LCD 相邻焊盘名义铜间距 0.20mm、阻焊桥 0.15mm。
- 长焊盘**不生成 F.Paste 开口**。屏幕尾排须在 PCB 元件回流完成后，用受控上锡和助焊剂手工焊接；不可按整条 5.5mm 焊盘开生产钢网或把裸屏一起回流。仍须检查全部 12 触点、桥连和焊接温度工艺。
- 删除原来包含未知尾排路径的旧整屏 3D 模型，避免用旧模型冒充新接口已经适配。

## 计算与原生检查结果

以两端屏长、两端 11.10±0.5mm、两端 2.00±0.2mm 组成 8 个角点，对全部 12 个焊盘计算纵向搭接；最小为 **0.9611mm**。另外用旧位置中心 156.21±0.5mm 和两端露铜长度做 4 个敏感性情景，最小搭接 1.8mm。共 **12×(8+4)=144 项**，全部满足项目选定的 0.75mm 最小纵向搭接。

**0.75mm 是本项目手工焊接的工程验收阈值，不是 POLCD 批准的焊接规范。** 旧位置情景是接口容差敏感性分析，不是实际弯折路径证据。通过纵向搭接也不能证明尾排在不受拉、不断铜的条件下能到达这里。

修订后的原生 KiCad 10 检查结果：所有严重级别 DRC=0、未连接=0、原理图一致性问题=0，ERC=0；本地 8 个封装库匹配。实际源 SHA 及每个焊盘坐标见 [计算记录](P133H002-interface-closure.json)。

## 复现和装配参考

在仓库根目录执行，仅使用 Python 标准库及同目录的工程解析模块，不修改 PCB、原理图或应用：

```sh
python3 tools/hardware/display_interface_allowance.py --output-dir /tmp/naive-display-interface
```

输出目录须为新目录或空目录。脚本读取当前显示板，核对 12 个焊盘尺寸、F.Cu/F.Mask、无 F.Paste、间距，并重生 JSON 和 [1:1 接口参考图](P133H002-interface-guide-1to1.svg)。图为 148×105mm，打印选择 100%，先量 **20mm 校准标尺**；它是装配基准图，不是钢网、生产光绘或已经试装的证明。

仍须确认 12pin 的横向对齐、露铜面与朝向、允许折弯区段/半径、背胶和焊点厚度、屏板承托及闭壳后的排线路径。没有这些资料时，不继续加宽 Y 向焊盘来掩盖不确定性，也不宣称屏幕机械接口全部闭合。
