guido233/HoloCubic/1.Hardware/RevB-KiCad/Naive/Closure/FFC-CABLE-SPEC.md

# Naive RevB 板间 FFC 接口定义 R1

本文件把电源/信号映射、裸铜接触面和端部尺寸变成可检查的要求。**当前没有样件，也没有唯一的显示板装配坐标，因此不发布排线长度或制造放行结论。** 机器可读定义、当前两块 PCB 的 SHA 及来源见 [ffc-interface.json](ffc-interface.json)。本文件不改变 PCB、原理图或既有 BOM。

## 1. 接头与逐线映射

两端均为 Hirose **FH12-8S-0.5SH(55)**，HRS 编号 CL0586-0744-5-55，8 位、0.5mm、底接触。插入后两端的裸铜/镀金接触面均须朝向各自 PCB。连接器本地引脚顺序和出线方向由实际受控封装确定，不能按屏幕朝向猜测。

| 主板 CON1 | 显示板 CON1 | 功能 |
| ---: | ---: | --- |
| 1 | 8 | GPIO5 / LCD_BL |
| 2 | 7 | GPIO4 / RES |
| 3 | 6 | GPIO23 / MOSI |
| 4 | 5 | GPIO18 / SCK |
| 5 | 4 | GPIO2 / D/C |
| 6 | 3 | GND |
| 7 | 2 | 3V3 |
| 8 | 1 | VDD_5V，负载开关后的 5V |

这张表来自最终原生 PCB 网名，兼容检查应逐项比较，不用“同向线/反向线”商品名称替代。连接器的 0.5A 额定不是全板电源保证；Hirose 对全部触点同时载流给出 70% 降额，实际负载还须结合温升预算验收。

来源：[Hirose 单品规格](https://www.hirose.com/en/product/p/CL0586-0744-5-55)、[FH12 系列目录](https://www.hirose.com/en/product/series/FH12/documents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)第 2、10、15-16 页。

## 2. 接触面方向的推导

采用八根平行、无交叉导体的普通 FFC，**摊平后两端接触露铜位于同一材料面**。Molex 对此称 Type A；供应商字母命名可以不同，采购图必须画出两个露铜面。该选型与两板都使用同一底接触接头共同实现 Main n 对 Ext 9-n。

这不是仅凭商品标题得出的判断。在每个接头定义：d 为排线从接头向外的方向，w 为 pin1 指向 pin8 的方向，n 为 PCB 正面法向。两端相同受控接头的局部关系均为 `d × w = -n`。连续线缆沿 A 端向外、沿 B 端向内；两端采用相同材料接触面时，导体编号轴在 A 与 w 同向、在 B 与 w 反向，因此接头编号倒序。两板整体旋转或倾斜不改变该局部编号关系，但会改变排线能否在壳内布置。

两端露铜位于不同材料面的无交叉排线会形成 Main n 对 Ext n，**不符合本电路**。例如主板 MOSI 会对到显示板 GND。不得靠强折排线或倒插接触面来尝试纠正。若使用交叉 FPC、转接板或不同接触手性的连接器，本推导不适用，必须重新给出整条映射。

Molex Type A / D 的面定义见其 [PS-15020-001 Rev F](https://www.molex.com/content/dam/molex/molex-dot-com/products/automated/en-us/productspecificationpdf/150/15020/PS-15020-001-001.pdf)第 3 页。此处电路映射是对当前两端实际封装的工程推导，仍须用被动夹具实测 8×8 导通矩阵确认成品。

## 3. 定制排线端部要求

内部图纸编号 **HC-N-FFC-08P05-SS-LVAR-R1**，不是供应商完整订货号。下表同时约束两个端部，单位 mm。数量、尺寸及相互位置应放在同一受控加工图中，不能逐项独立取极限而破坏整体几何。

| 项目 | 定制图要求 | 依据 |
| --- | ---: | --- |
| 导体数量 | 8 | 当前两板接口 |
| 相邻中心距 | 0.50 ±0.05 | Hirose FH12 推荐端部图 |
| 首末导体中心跨度 | 3.50 ±0.05 | 8 位 FH12 图的 A 尺寸 |
| 总宽 | 4.50 ±0.07 | 8 位 FH12 图的 B 尺寸 |
| 导体宽 | 0.30 ±0.03 | Hirose 的 FFC 项，不能误用 FPC 宽度项 |
| 边缘到最外导体中心 | 0.50 ±0.10 | Hirose 推荐端部图 |
| 插入区总厚度 | 0.30 ±0.05 | Hirose 适用端厚 |
| 补强片本身厚度 | 至少 0.188 | Hirose FPC/FFC 构造注释；须同时满足插入区总厚，不能简单额外叠加 |
| 裸铜接触长度 | 4.00 ±0.25 | 工程收紧，最小 3.75，覆盖 FH12 图的 3.5 最小要求 |
| 端部补强长度 | 6.00 ±0.50 | 工程收紧，最小 5.50，覆盖 FH12 图的 4.5 最小要求 |
| 接触表面 | 镀金 | Hirose 适配接触材料要求 |
| 摊平后的露铜面 | 两端同面 | 第 2 节的无交叉导体映射 |
| 总长 L | **未定，不可填默认 60mm** | 第 4 节装配输入不足 |

端部总厚度合格不能代替补强、绝缘层和导体构成的适配确认。供应商须按 FH12 目录对应的 FFC 构造图确认层材与补强，提交有公差的加工图。上表中收紧的裸铜和补强长度是本项目工程要求，不冒充厂家既有产品规格。

图形归属另用 [DigiKey 留存的 Hirose 原厂目录](https://media.digikey.com/pdf/Data%20Sheets/Hirose%20PDFs/FH12_Series.pdf)第 11 页直接渲染复核：3.5MIN 对应接触露铜，4.5MIN 对应背面补强长度，8 位 A=3.5/B=4.5，以及 FFC 与 FPC 的导体宽度项分别列出。该存档 PDF 创建于 2014 年，不冒充当前官网版本；当前官网目录第 10 页的同名尺寸已文本交叉核对，生产前仍须供应商按当前受控图确认。核对散列见 [图形复核记录](ffc-endpoint-visual-review.json)。

## 4. 长度与壳内路径

当前显示板与上壳尚未建立唯一的装配变换，两个历史倾角也不一致。因此不能从两个 PCB 的各自 XY 坐标直接算出板间距离，不能把社区约 60mm 当作最终长度。

待锁定输入包括：两板刚体装配变换、成品板厚、连接器实际插入止挡/出线方向、LCD 与尾排包络、连接器开盖扫掠、壳筋、装配顺序、供应商允许的静态弯曲半径及补强区禁弯长度。

统一按两端切口的 tip-to-tip 长度定义：

`L = A端插入长度 + B端插入长度 + Σ直线段 + Σ(中性层弯曲半径 × 弯曲角弧度) + 装配余量`

插入长度必须取接头图纸/实际止挡，不把裸铜长度当插入长度。余量是明确的可容纳服务弯，不是任意多出的线长；还需验证最长公差的排线不会顶压器件或壳体、最短公差的排线不受拉力。

Molex 规格中的 3mm 直径冷绕试验、手动折叠试验和 R=10mm 寿命试验是各自测试条件，**没有直接给出本装配允许的最小永久弯曲半径**，不得任取其中一个数作为整机放行依据。

## 5. 已查到的完整料号：仅供有条件取样

以下原厂单品身份明确，均为 8 位、0.5mm、镀金、摊平后露铜同面，电气布局类型符合第 2 节：

| 厂家料号 | tip-to-tip 名义长度 | 总长公差 | 两端补强之间的长度范围 | 状态 |
| --- | ---: | ---: | ---: | --- |
| [Molex 15020-0075](https://www.molex.com/en-us/products/part-detail/150200075) | 51 | ±2 | 35..43 | 有条件样品候选 |
| [Molex 15020-0077](https://www.molex.com/en-us/products/part-detail/150200077) | 76 | ±3 | 59..69 | 有条件样品候选 |

补强间长度范围按其 Rev F 的两端补强各 6±1mm 计算，仅是可弯区域的初步尺寸界限，未证明壳内路径可达或可容纳。当前不推荐其中任一长度为整机最终采购项。

两者存在需要处理的端部公差差异：Molex 通用规格的跨度/总宽公差均为 ±0.10，宽于 FH12 推荐的 ±0.05 / ±0.07；裸铜 4.00±0.80 的最小值 3.20，也小于 FH12 推荐的 3.5 最小值。端厚 0.30±0.05 和导体宽 0.30±0.03 虽相符，不能据此推断所有批次完全兼容。须取得厂家书面适配/受控尺寸确认，或检验并验证实际样品批次；如无法取得，应按第 3 节定制。

对应的 [15020-0076](https://www.molex.com/en-us/products/part-detail/150200076) 和 [15020-0078](https://www.molex.com/en-us/products/part-detail/150200078) 是异面 Type D，不适用本版要求，不能只按相同针数和长度代换。Molex 的产品页在文本中带有限资料模板，本次仅使用可核实的具体尺寸/面型，不据该模板推断供货状态。

公差、导体电阻和测试条件的原厂依据：[Molex PS-15020-001 Rev F，第 2-4 页](https://www.molex.com/content/dam/molex/molex-dot-com/products/automated/en-us/productspecificationpdf/150/15020/PS-15020-001-001.pdf)。

## 6. 实物闭合步骤

1. 使用两个**无 IC、无电源连接的被动 FH12 测试夹具**，确认端部尺寸、铜面朝向、全部插入与锁扣闭合。切勿先把未知排线插在整机上通电。
2. 测量 8×8 导通矩阵：仅允许 1↔8、2↔7、3↔6、4↔5、5↔4、6↔3、7↔2、8↔1。扣除表笔电阻后各目标路径应小于 1Ω；其他路径不得出现低阻。这个 1Ω 是抓错线/断线的工程筛查门槛，不是对接头接触电阻的认证。
3. 整机不通电试装，验证插入、锁闭、开盖均可操作；排线没有拉力、锐折、与裸铜/焊点/壳筋相擦，闭壳不产生预载。锁定路径后发布 L 和公差。
4. 在限流上电后，按最终排线测试 10MHz 显示时序与画面稳定性，并与 SD/WiFi 并发及温度/电源范围验证结合。

已装器件的两板存在上拉电阻和半导体路径，不能照搬“被动线缆夹具”的绝缘/导通判据去判断整块电路板。没有实际样件结果时，步骤不得标记为通过。
