guido233/HoloCubic/1.Hardware/RevB-KiCad/Naive/PURCHASING.md

# 单台材料与采购边界

板上元件以实际原理图导出的 [BOM.csv](BOM.csv)、[合并采购表](BOM-grouped.csv) 和 [采购 Excel](BOM.xlsx) 为准；可追溯数据为 [BOM.json](BOM.json)。2026-10-30 已应用本轮样机替代选型，主板 58 个位号、显示板 11 个位号，共 69 件、38 个完整 MPN 采购行。数量为装机用量，小贴片按包装量另留备件。来源及停产风险见 [BOM 审查](BOM-review.md)。MPU-6050 已停产，ESP32-PICO-D4 为 NRND；先确认可追溯来源再决定制作。

## 已应用的样机替代料

| 位置 | 当前订货号 | 每台用量与采购说明 |
| --- | --- | --- |
| 主板 C24、显示板 C4 | Murata GRM188R71E105KA12D / C86020 | 1µF、25V、X7R、0603，每处 1 颗，合计 2 颗；共用同一采购包，不要按两个位号各买一包。主板 C4 仍为 22µF / 0805。 |
| 主板 U6 | TI TPS22918DBVT / C2680345 | 1 颗；与原 DBVR 同芯片、DBV6 外形和引脚，仅载带包装不同，不改变电气或固件。 |
| 主板 R3 | RALEC RTT022000FTH / C102869 | 1 颗；200Ω、1%、1/16W、0402，保持 UART 串联用途。不要与显示板同名的 100kΩ R3 混淆。 |

这是已写入本版工程的首台样机选型，尚未实测，也未作量产放行。2026-10-30 商城核对时，C86020 的 20 颗包报价为 ¥5.78，一台用 2 颗后余 18 颗；U6 的 C2680345 为 **0 现货、可订货**，5 颗报价 ¥4.56，交期未确认；R3 的 C102869 为 100 颗 ¥1.28。以上均是不含运费的当日库存／报价快照，不是持续供货、价格或交期承诺，下单时须重新核实。

## 整机材料

| 材料 | 单台数量 | 规格及采购前提 |
| --- | ---: | --- |
| MainBoard、ExtendBoard PCB | 各 1 | 主板六层、显示板两层，按最终 RevB 工程、板厂确认的层叠及对应钢网/装配资料加工。原生布线检查已通过，层叠与装配条件确认完成前暂不下单；不要直接采购原 Altium 裸板搭配新料。 |
| 板上器件 | 共 69 件 | 详见 BOM；包括 1 块裸屏，不含下面外购物料。 |
| 屏幕样品 | 1 | P133H002 为电气候选，已计入 69 件。12pin、0.7mm 尾排；显示板已改为 5.5mm 长焊接区、无 F.Paste，PCBA 后手工焊 FPC。纵向落区已计算，折弯/横向/整壳仍须确认。不能用带转接 PCB 的通用 ST7789 模块代替。 |
| 分光立方体 | 1 | 25.4×25.4×25.4mm，原作者指定为分光棱镜。原资料未锁定偏振类型、镀膜或分光比；不要把社区商品的 1:1 比例当原厂设计参数。 |
| OCA 固态光学胶 | 少量 | 屏幕与棱镜贴合用，按贴合面裁切；原资料未锁定厚度。先确认偏振方向及成像后固定。 |
| 板间 FFC | 1 | 8pin、0.5mm、端部总厚 0.30±0.05mm，摊平后两端露铜同面、无交叉导体。按 [定制端部要求](Closure/FFC-CABLE-SPEC.md)询价，长度仍待壳内路径确定；Molex 51/76mm 只是有条件样品候选，不能替代公差核对和 Main n↔Ext 9−n 实测。 |
| Naive 上壳 | 1 | 原 `4.3D Model/Naive Version/Upper.step`。 |
| RevB 下壳 | 1 | 使用 [Lower-RevB.step](Mechanical/Lower-RevB.step)，内部有新增元件避让槽。打印尺寸、承托就座与整机装配仍需试装。 |
| 紧固件 | 4 | 模型有四组孔。M2×8、头径小于 4mm/头高小于 3mm 可作为试装候选；上壳为 Ø1.5mm 盲孔，未定义螺纹，机牙/自攻牙及长度由打印方确认。 |
| USB 数据线 | 1 | USB-A→USB-C 或符合供电条件的 USB-C→USB-C，必须带数据；用于 CP2102 下载和供电。USB 两种插入方向都要实测。 |
| 5V 电源 | 1 或复用 | 建议额定至少 1A，并留意线损；这不是整机实测功耗。不能假定电脑 USB 2.0 的 500mA 端口可支持满负载。 |
| microSD/TF 卡 | 建议 1 | FAT32；8–32GB 可作为兼容性样品范围，须用所购卡测试资源读取。更换卡需要拆下壳。 |
| 读卡器 | 按需 | 用于写入资源与配置。 |
| 装配辅料与工具 | 按需 | 无尘擦拭/除尘用品、镊子、合适螺丝刀；自行焊裸屏需焊台、助焊剂及放大检查。0402/QFN 建议交有能力的贴片厂。首次上电需限流电源和万用表；时序及热插拔检查需示波器。 |

## PCB 询价与制造条件

主板已选择公开的 **JLC06101H-3313** 六层、订单名义 1.0mm 模板，并保存官方模板响应。铜与介质合计 1.04mm，加当前双面阻焊预算后 CAD 为 **1.06mm**，已据此更新机械筛查。询价须按 [逐项制造约定](Closure/STACKUP-SPEC.md)回签材料、成品铜、含阻焊总厚、公差、ENIG 及孔处理，不能把公开模板选择当成订单已经接受，也不宣称控阻抗或 RF 已认证。

制造商还须确认 0.1016mm 局部线宽、0.127mm 铜间距、0.25mm 成品孔和至少 0.10mm 孔环；电源主干使用更宽走线。USB1 厂图内部约 0.194mm 孔间距由局部 0.19mm 规则检查，需单独获得工艺确认，不能全板放宽。主板采用密集双面贴装、0402 和 QFN，PICO 分窗钢网、21 个指定热孔填孔盖镀目标及底面阻焊、MPU 中心禁焊要求需交给装配方确认；器件槽孔不可一并填掉。两板严格阻焊规则已通过，LCD 长焊区不做回流钢网开口。下单版本仍须完成原生检查与实际工艺回签。

外壳、尾排、天线与电源的验收条件见 [工程说明](README.md) 和 [机械审查](MECHANICAL-REVIEW.md)。这些未完成的条件应保留在询价和打样备注中；一份完整 MPN 表不代表整机已通过实物验证。

CSV 中的位置与角度是原生 CAD 工程坐标，不能直接当作某台贴片机的作业文件。尤其 LCD1 的屏体在背面、尾排焊盘在正面，须按折弯装配图单独处理。
