guido233/HoloCubic/1.Hardware/RevB-KiCad/Naive/MainBoard/3dmodels/Molex_1040310811_KiCad_F_frame.step

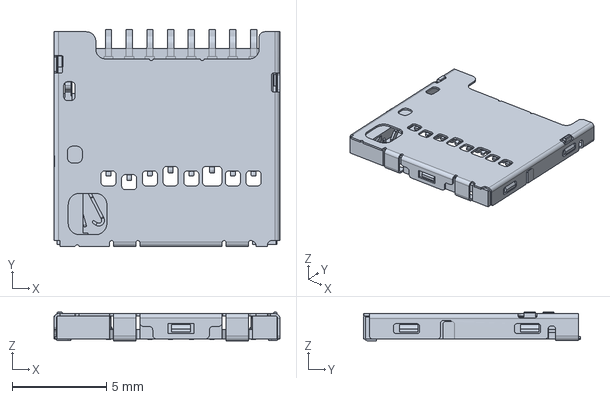
[picture p1: CAD file, 2026-10-29]
1.Hardware/RevB-KiCad/Naive/MainBoard/3dmodels/Molex_1040310811_KiCad_F_frame.step
12.0 x 11.5 x 1.53 mm
