guido233/HoloCubic/1.Hardware/RevB-KiCad/Naive/Mechanical/Lower-RevB.step

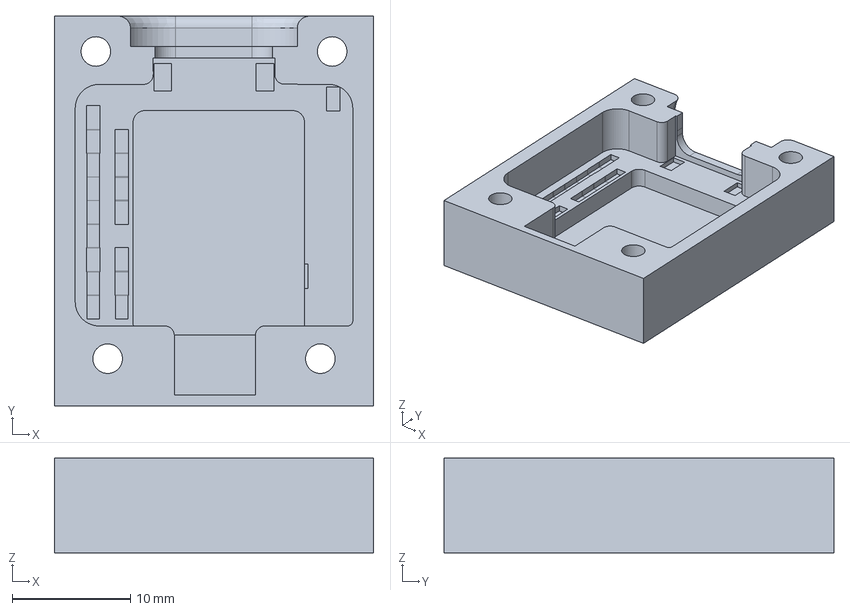
[picture p2: CAD file, 2026-10-30]
1.Hardware/RevB-KiCad/Naive/Mechanical/Lower-RevB.step
27.0 x 33.0 x 8.00 mm
