guido233/HoloCubic/1.Hardware/RevB-KiCad/Naive/MainBoard/3dmodels/CA-C03_MaxBody_Bounding_Envelope.step

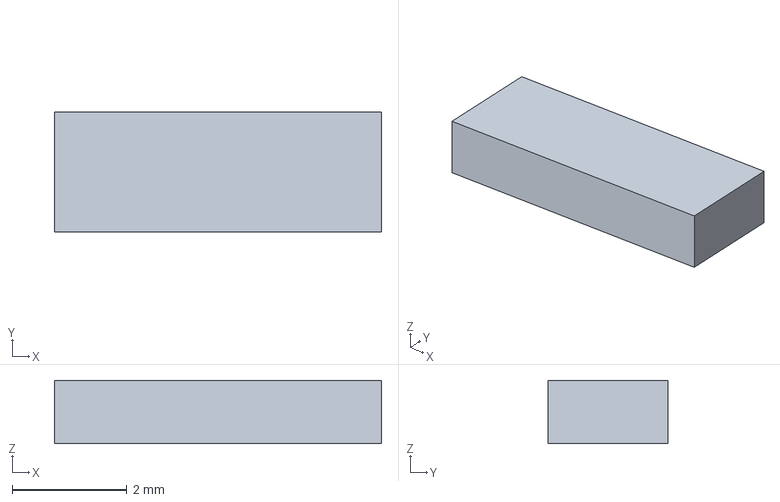
[picture p3: CAD file, 2026-10-29]
1.Hardware/RevB-KiCad/Naive/MainBoard/3dmodels/CA-C03_MaxBody_Bounding_Envelope.step
5.70 x 2.10 x 1.10 mm
