guido233/HoloCubic/1.Hardware/RevB-KiCad/Naive/MainBoard/3dmodels/ESP32-PICO-D4_MaxBody_Bounding_Envelope.step

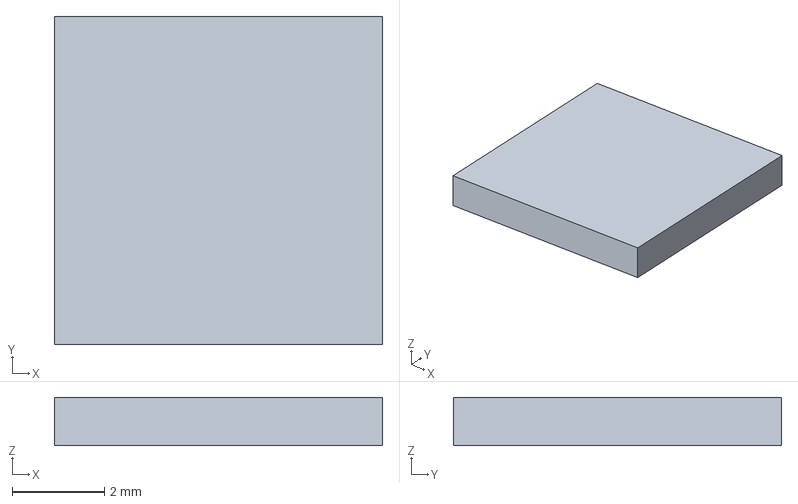
[picture p4: CAD file, 2026-10-29]
1.Hardware/RevB-KiCad/Naive/MainBoard/3dmodels/ESP32-PICO-D4_MaxBody_Bounding_Envelope.step
7.10 x 7.10 x 1.04 mm
