guido233/HoloCubic/1.Hardware/RevB-KiCad/Naive/MainBoard/3dmodels/TI_DSG0008A_MaxBody_Bounding_Envelope.step

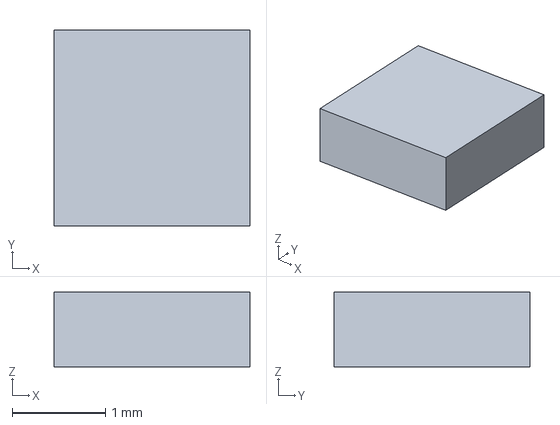
[picture p5: CAD file, 2026-10-29]
1.Hardware/RevB-KiCad/Naive/MainBoard/3dmodels/TI_DSG0008A_MaxBody_Bounding_Envelope.step
2.10 x 2.10 x 0.8 mm
