guido233/HoloCubic/1.Hardware/RevB-KiCad/Naive/MainBoard/3dmodels/Diodes_SOT23_MaxBody_Bounding_Envelope.step

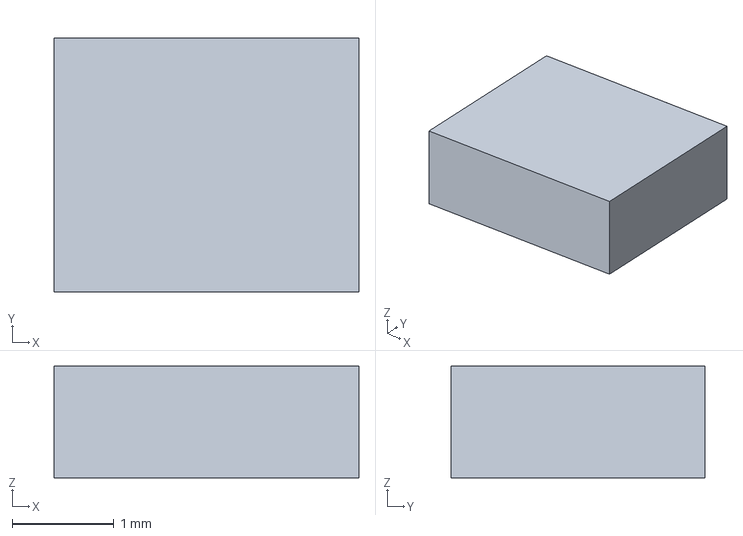
[picture p6: CAD file, 2026-10-29]
1.Hardware/RevB-KiCad/Naive/MainBoard/3dmodels/Diodes_SOT23_MaxBody_Bounding_Envelope.step
3.00 x 2.50 x 1.10 mm
