guido233/HoloCubic/1.Hardware/RevB-KiCad/Naive/MainBoard/3dmodels/TDK_VLS3012HBX_MaxBody_Bounding_Envelope.step

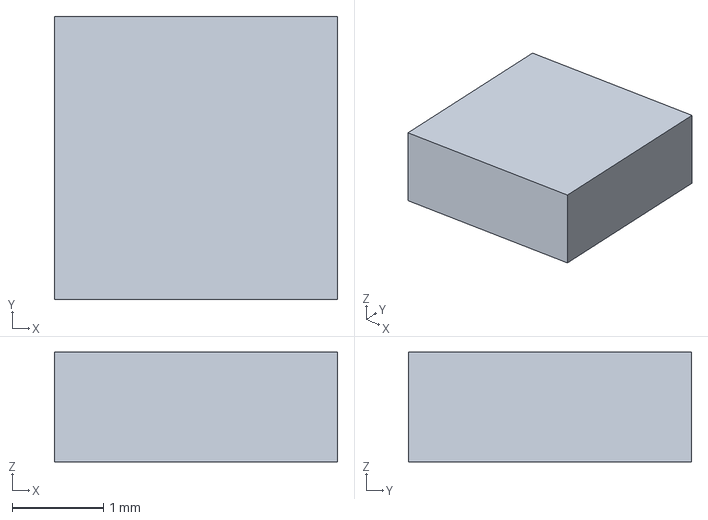
[picture p7: CAD file, 2026-10-29]
1.Hardware/RevB-KiCad/Naive/MainBoard/3dmodels/TDK_VLS3012HBX_MaxBody_Bounding_Envelope.step
3.10 x 3.10 x 1.20 mm
