guido233/HoloCubic/1.Hardware/RevB-KiCad/Naive/MainBoard/3dmodels/TI_DPY0002A_MaxBody_Bounding_Envelope.step

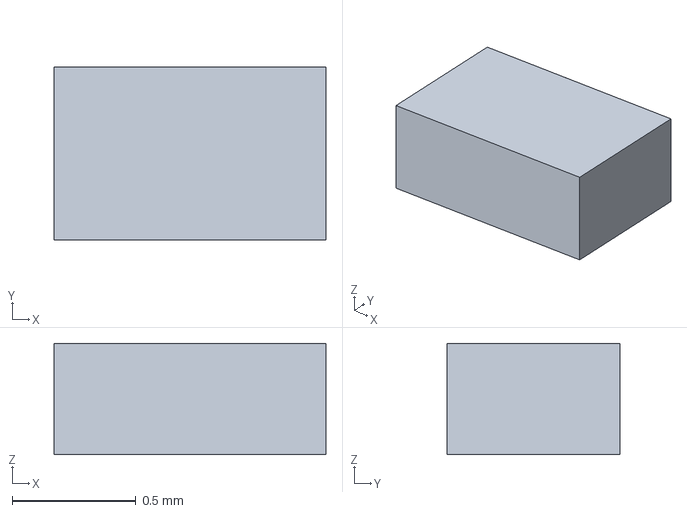
[picture p8: CAD file, 2026-10-29]
1.Hardware/RevB-KiCad/Naive/MainBoard/3dmodels/TI_DPY0002A_MaxBody_Bounding_Envelope.step
1.10 x 0.7 x 0.45 mm
