guido233/HoloCubic/1.Hardware/RevB-KiCad/Naive/Closure/BRINGUP.md

# 首板验证与诊断固件

本文件定义未来样机如何验收。当前仅有文件与图纸，下面各项**均未实测**。编译通过、器件响应或串口中的某一个 PASS 不代表整机可用。

2026-10-30 样机选型已应用：Main C24 与 Extend C4 共用 GRM188R71E105KA12D，U6 为 TPS22918DBVT，Main R3 为 RTT022000FTH。主板 C4 仍为 22µF。此次不改变供电网络、接口或固件；下面的波形和功能验收仍须对实际装配批次执行。

## 测量位置

[probe-map.svg](probe-map.svg) 分别画出两板正反面；[坐标表](probe-map.csv) 和 [来源 SHA](probe-map.json) 从实际 PCB 导出。M1 等编号是文档编号，指现有元件端子，并未在 PCB 新增测试焊盘；探针接触空间须由操作者确认，必要时在装壳前接短测量线。

| 信号 | 位置 | 验收要求 |
| --- | --- | --- |
| USB_VBUS | M1 / C15.1 | 本项目用连接器端 4.75、5.00、5.25V 三档受控输入验证；这是工程测试范围 |
| 系统 5V | M2 / C20.1 | CP2102 REGIN 工作范围为 4.0–5.25V；检查启动和负载瞬态，不以 5.5V 当允许工作值 |
| CP_VDD | M3 / C18.1 | 稳态 3.0–3.6V；按原厂 VDD ramp 定义，VDD 自身开始爬升至 2.7V 不超过 1ms，保存原始波形与起点定义；不从 USB 插入事件计入 ON 延迟，也不以 10–90% 典型估算替代 |
| 3V3、3V3A | M4 / C13.1，M5 / C4.2 | 稳态项目目标 3.135–3.465V（工程 ±5%），工作瞬态保持芯片要求的 3.0–3.6V |
| MCU EN | M6 / C7.1 | 启动稳定后释放；自动下载/reset 时序与供电波形一起记录 |
| GND | M7 / C20.2 | 示波器使用短接地弹簧，先确认与输入电源共地 |
| BH1750 VCC | M10 / C11.1，与 U5.1 同网 | 与 DVI 同时捕获；记录实际到达 2.4V 的时刻及完整升降沿 |
| BH1750 DVI | M11 / C24.1，与 U5.5 同网；C24.2 为地 | VCC 达到 2.4V 后，DVI 仍须保持 ≤0.4V 至少 1µs；见下述复位验收 |
| CC1、CC2 | M8 / R12.1，M9 / R13.1 | 断电分别核独立 5.1kΩ Rd；USB-C 两种方向分别测枚举与热插拔 |
| 显示板 5V / 3V3 | E1 / C3.1，E2 / C1.1 | 与主板同时测，包含真实排线压降与背光负载 |
| 背光电流 | E3 / R2.1 对 E4 / R2.2 | 测 R2 两端电压和实际电阻，按 I=V/R 求电流；不能从 PWM 百分比推算瞬时电流 |

CP2102 限值来自 [Silicon Labs CP2102/9 Rev1.8 Tables3/5/6](https://www.silabs.com/documents/public/data-sheets/CP2102-9.pdf)；MCU 电源范围来自 [Espressif PICO 系列 Table17](https://documentation.espressif.com/esp32-pico_series_datasheet_en.html)。3V3 稳态 ±5%、三档输入及下述重复次数是本项目的首板筛查要求，并非厂家认证测试。

不要用普通探头直接测 C16 的 100pF CT 节点来代替 CP_VDD 波形；探头电容会改变该时间常数。BUCK_SW 也不是稳压输出测点。

## 上电与记录顺序

1. 先核 PCB/装配版本及器件方向，记录裸板、装配板、屏幕和线缆照片。保持断电，核对 5V/3V3/GND、USB 及 FFC 的无误装/桥连情况；线缆导通用 [FFC 定义](FFC-CABLE-SPEC.md) 的独立被动夹具判据。
2. 先不接屏幕、排线和 SD，用限流实验电源从 USB_VBUS 输入端供电。低限流仅用于排除装配短路，不把限流导致的反复复位当成固件失败；确认电压与无异常温升后再按实际负载调整，记录限流设定与入口电流。不得向 CP_VDD 或 3V3 输出反向灌电。
3. 首次确认 M1–M6 的静态值和启动波形。输入每档重复冷启动及 USB 两种方向插入各 10 次，保存 CP_VDD、VDD_5V、3V3A 波形、枚举记录及是否复位。不能只填“看起来正常”。
4. 接入已核对的屏幕和排线，背光先保持关闭。测背光调节全范围的导通电流、稳态温升和电源范围；P133H002 的总背光电流不得超过其已引用规格书的 40mA 最大值，约 24mA 只是典型估算。没有电流结果时不以全亮画面代替验收。
5. 使用下述诊断固件做局部功能检查，再换回正式 `naive` 固件验证界面、SD 资源、传感器和网络。10MHz 显示仍需在屏端实测时序、过冲与振铃；软件时钟设定不等于接收端波形已通过。
6. 最终外壳、棱镜、背胶、排线均装好后，做至少 30 分钟 SD/WiFi/显示并发运行并记录重启计数、错误、温升及画面。环境/温度范围须按实际用途另行约定；这不是完整可靠性认证。
7. 天线需在最终叠层和闭壳状态下完成匹配及无线性能测试。`wifi-scan`、连接成功和 RSSI 都不能代替 VNA/天线匹配结果；由测试方记录测试夹具、校准面、频段和所用验收指标。

## BH1750 VCC/DVI 复位验收

本项在上述主板电源检查之后、连接屏幕负载之前进行。U5 的 DVI 是 I²C 参考电压兼异步复位端，由 R11=1kΩ / C24=1µF 形成硬件延迟；本次 25V X7R 料仍保持该标称 RC。它不是 MCU 可直接拉低的复位脚，软件多等一段时间不能补出缺失的异步复位低电平。

同时探测 **M10 / C11.1（U5 VCC）与 M11 / C24.1（DVI）**，地接 C24.2 或附近同网地，采用短接地回路。保存探头倍率、带宽、采样率、触发点和原始波形，时间分辨率须能判断 1µs 区间。按 [ROHM BH1750FVI Rev.D 第 6、8、9 页](https://mm.digikey.com/Volume0/opasdata/d220001/medias/docus/6165/bh1750fvi-e.pdf)检查：**在 VCC 达到工作下限 2.4V 后，DVI 仍保持 ≤0.4V 的区间至少为 1µs**。记录两个阈值的交越时刻及区间长度，随后确认 DVI 恢复到允许的 I²C 参考电压范围，再检查通信和光照响应。原始附件及结论对应记录表的 `bh1750_dvi_reset` 项；无数据时保持 `NOT_TESTED`。

分别完成以下工况，沿用前述受控输入范围，并记录芯片端实际波形：

1. **冷启动**：完整断电后测出 VCC、DVI 的实际初始电压，再上电。不能把仍有残压的重启写成冷启动。记录 VCC 上升时间、DVI 复位区间及之后的光照响应。
2. **慢上电与棕断恢复**：使用可重复的慢升输入及受控电源跌落，记录 U5 VCC 的实际升降速率和最低值，不用电源面板设置代替芯片端电压。检查每次恢复时的 DVI 低电平区间和共享 I²C 是否恢复，记录失败工况，不只保留成功波形。
3. **快速断电重插**：记录断电至重新上电的实际间隔、VCC 降到 ≤0.05V 的时刻、重新上电前 VCC / DVI 残压，以及 DVI 高于 VCC 的幅度和持续时间；逐次判断复位阈值区间并重复读取。必须保存实际掉电及回升过程，不能假定 USB 拔下就已完全放电。

ROHM 第 9 页的“升到 2.4V 不超过 100µs、VCC≤0.05V 后等待 25ms”属于 **VCC=2.8V 的 CR 应用示例**，不是本 3.3V 板已经验证的通用保证。不得只按标称 τ=1ms、25V 耐压或单次 ACK 把本项填成通过；须结合实际电源、偏压后电容、放电路径及批次波形判断。没有实测时，本项及残压数据保持未测试，不填推算值或虚构的 0V。

默认 `naive` 固件尚未调用 BH1750，也未启用自动调光；本次替代不改固件或启用功能。`naive-bringup` 的 `i2c` 命令在发出 0x20 后等 180ms 再读取，符合默认高分辨率最大转换等待；但其结果只证明当次事务。现有未使用的 `Ambient` helper 仍需修正计时基准、最大转换等待和 I²C 读取检查，不能直接启用；0x07 软件命令只清光照数据寄存器，不能代替 DVI 硬件上电复位。

## 独立诊断固件

新增 `naive-bringup` 环境，不改变默认 `naive` 固件。只有明确选择此环境才编译诊断入口；程序默认关闭背光，不自动访问 SD 或联网。板上供电测试应先于烧录。

```sh
pio run -d 2.Firmware/HoloCubic-fw -e naive-bringup
# 有实物、供电检查通过并选定串口后，由操作者执行：
pio run -d 2.Firmware/HoloCubic-fw -e naive-bringup -t upload --upload-port <串口>
pio device monitor -d 2.Firmware/HoloCubic-fw -e naive-bringup --port <串口> -b 115200
```

每条命令用换行结束。超过 95 字符的输入整行拒绝。

| 命令 | 实际动作与结果边界 |
| --- | --- |
| `status` | 芯片修订、Flash、SDK 和配置；始终明确外部装配/波形/温升/RF 未验证 |
| `i2c` | 检查 MPU WHO_AM_I/14 字节数据和 BH1750 读取；改变姿态和光照反复比对，ACK 不等于校准合格 |
| `display` | 发送 RGB 条纹和四角编号；保持正式固件相同的镜像设置，需人工通过棱镜确认画面、方向和缺线 |
| `backlight 0..100` | 设置 GPIO5 反相 PWM；没有测量电流或温度的能力 |
| `rgb` | 低亮度依次发送红/绿/蓝，随后关闭；必须人工确认实物颜色 |
| `sd-status` | 按 GPIO14/26/13/15 和 4MHz 挂卡，报告容量和类型 |
| `sd-test` | 仅当 `/holocubic-bringup.bin` 不存在时新建 64KiB 文件，逐块写读比对并删除；存在则拒绝，不覆盖用户文件 |
| `wifi-scan` | 同步扫描并报告数量/最强 RSSI，不打印网络名称；扫描接口成功不代表天线合格 |
| `wifi-load` | 读取 SD `/wifi.txt` 前两行作为测试 AP 凭据，连接最长等待 15s，连接后同时读 SD/刷新屏幕 10s；不打印凭据、不做 HTTP 请求，结束断开 |

`wifi-load` 只验证本地功能冒烟，不产生持续网络吞吐负载，不能代替功耗最坏工况、丢包率或 RF 测试。恢复正式程序使用 `-e naive` 重新烧录。当前诊断固件仅完成编译与代码检查，尚未在板上执行。

## 交回的实际证据

每份记录注明操作者、板号、PCB/固件 SHA、物料批次、仪器/探头、供电、环境条件、原始附件及结论。用 [measurement-record.csv](measurement-record.csv) 填真实读数，保留原始波形/照片/串口日志。没有样机或没有测量的项目保持 `NOT_TESTED`，不要填 0、N/A 或用其他项目的 PASS 替代。
