guido233/HoloCubic/1.Hardware/RevB-KiCad/Naive/Closure/measurement-record.csv

test_id | board_serial | pcb_sha256 | firmware_sha256 | operator | instrument | condition | measured_value | unit | criterion | result | evidence_file
cp_vdd_rise |  |  |  |  |  | input4.75/5.00/5.25V;10 starts each |  | ms | to2.7V<=1ms | NOT_TESTED
cp_vdd_steady |  |  |  |  |  | same input range |  | V | 3.0..3.6 | NOT_TESTED
regin_envelope |  |  |  |  |  | startup/load/USBhotplug |  | V | 4.0..5.25 | NOT_TESTED
3v3_steady |  |  |  |  |  | SD/WiFi/display load |  | V | 3.135..3.465 project target | NOT_TESTED
3v3a_transient |  |  |  |  |  | SD/WiFi/display load |  | V | 3.0..3.6 | NOT_TESTED
backlight_current |  |  |  |  |  | full PWM,input range,temperature |  | mA | <=40 total | NOT_TESTED
display_visual |  |  |  |  |  | actual P133+FFC+prism |  |  | colors/corners/stability | NOT_TESTED
ffc_matrix |  |  |  |  |  | isolated passive fixture |  |  | only n<->9-n | NOT_TESTED
screen_registration |  |  |  |  |  | actual screen,adhesive,board,case |  | mm | overlap and bend per display drawing | NOT_TESTED
usb_both_orientations |  |  |  |  |  | 10 insertions each direction |  |  | enumerate/reset/download | NOT_TESTED
imu_light_response |  |  |  |  |  | vary orientation and illumination |  |  | response observed and logged | NOT_TESTED
bh1750_dvi_reset |  |  |  |  |  | M10 VCC/M11 DVI to C24.2 GND; cold/slow rise/brownout/rapid replug; record residual voltage |  | us | after VCC reaches2.4V DVI<=0.4V for>=1us; preserve both waveforms | NOT_TESTED
sd_wifi_display_30min |  |  |  |  |  | final enclosure |  |  | no resets/read errors/unstable picture | NOT_TESTED
thermal |  |  |  |  |  | final enclosure and declared ambient |  | degC | limits agreed with component/assembly requirements | NOT_TESTED
rf_final_enclosure |  |  |  |  |  | calibrated RF fixture,VNA and functional test |  |  | test criteria and calibration recorded | NOT_TESTED
