guido233/HoloCubic/(list of files, drawings)

Other design files:
1.Hardware/RevB-KiCad/Naive/MainBoard/schematic_expected_nets.json
