guido233/HoloCubic/1.Hardware/RevB-KiCad/Naive/MainBoard/MainBoard.kicad_pcb

## KiCad design 1.Hardware/RevB-KiCad/Naive/MainBoard/MainBoard.kicad_pcb (2026-10-30)

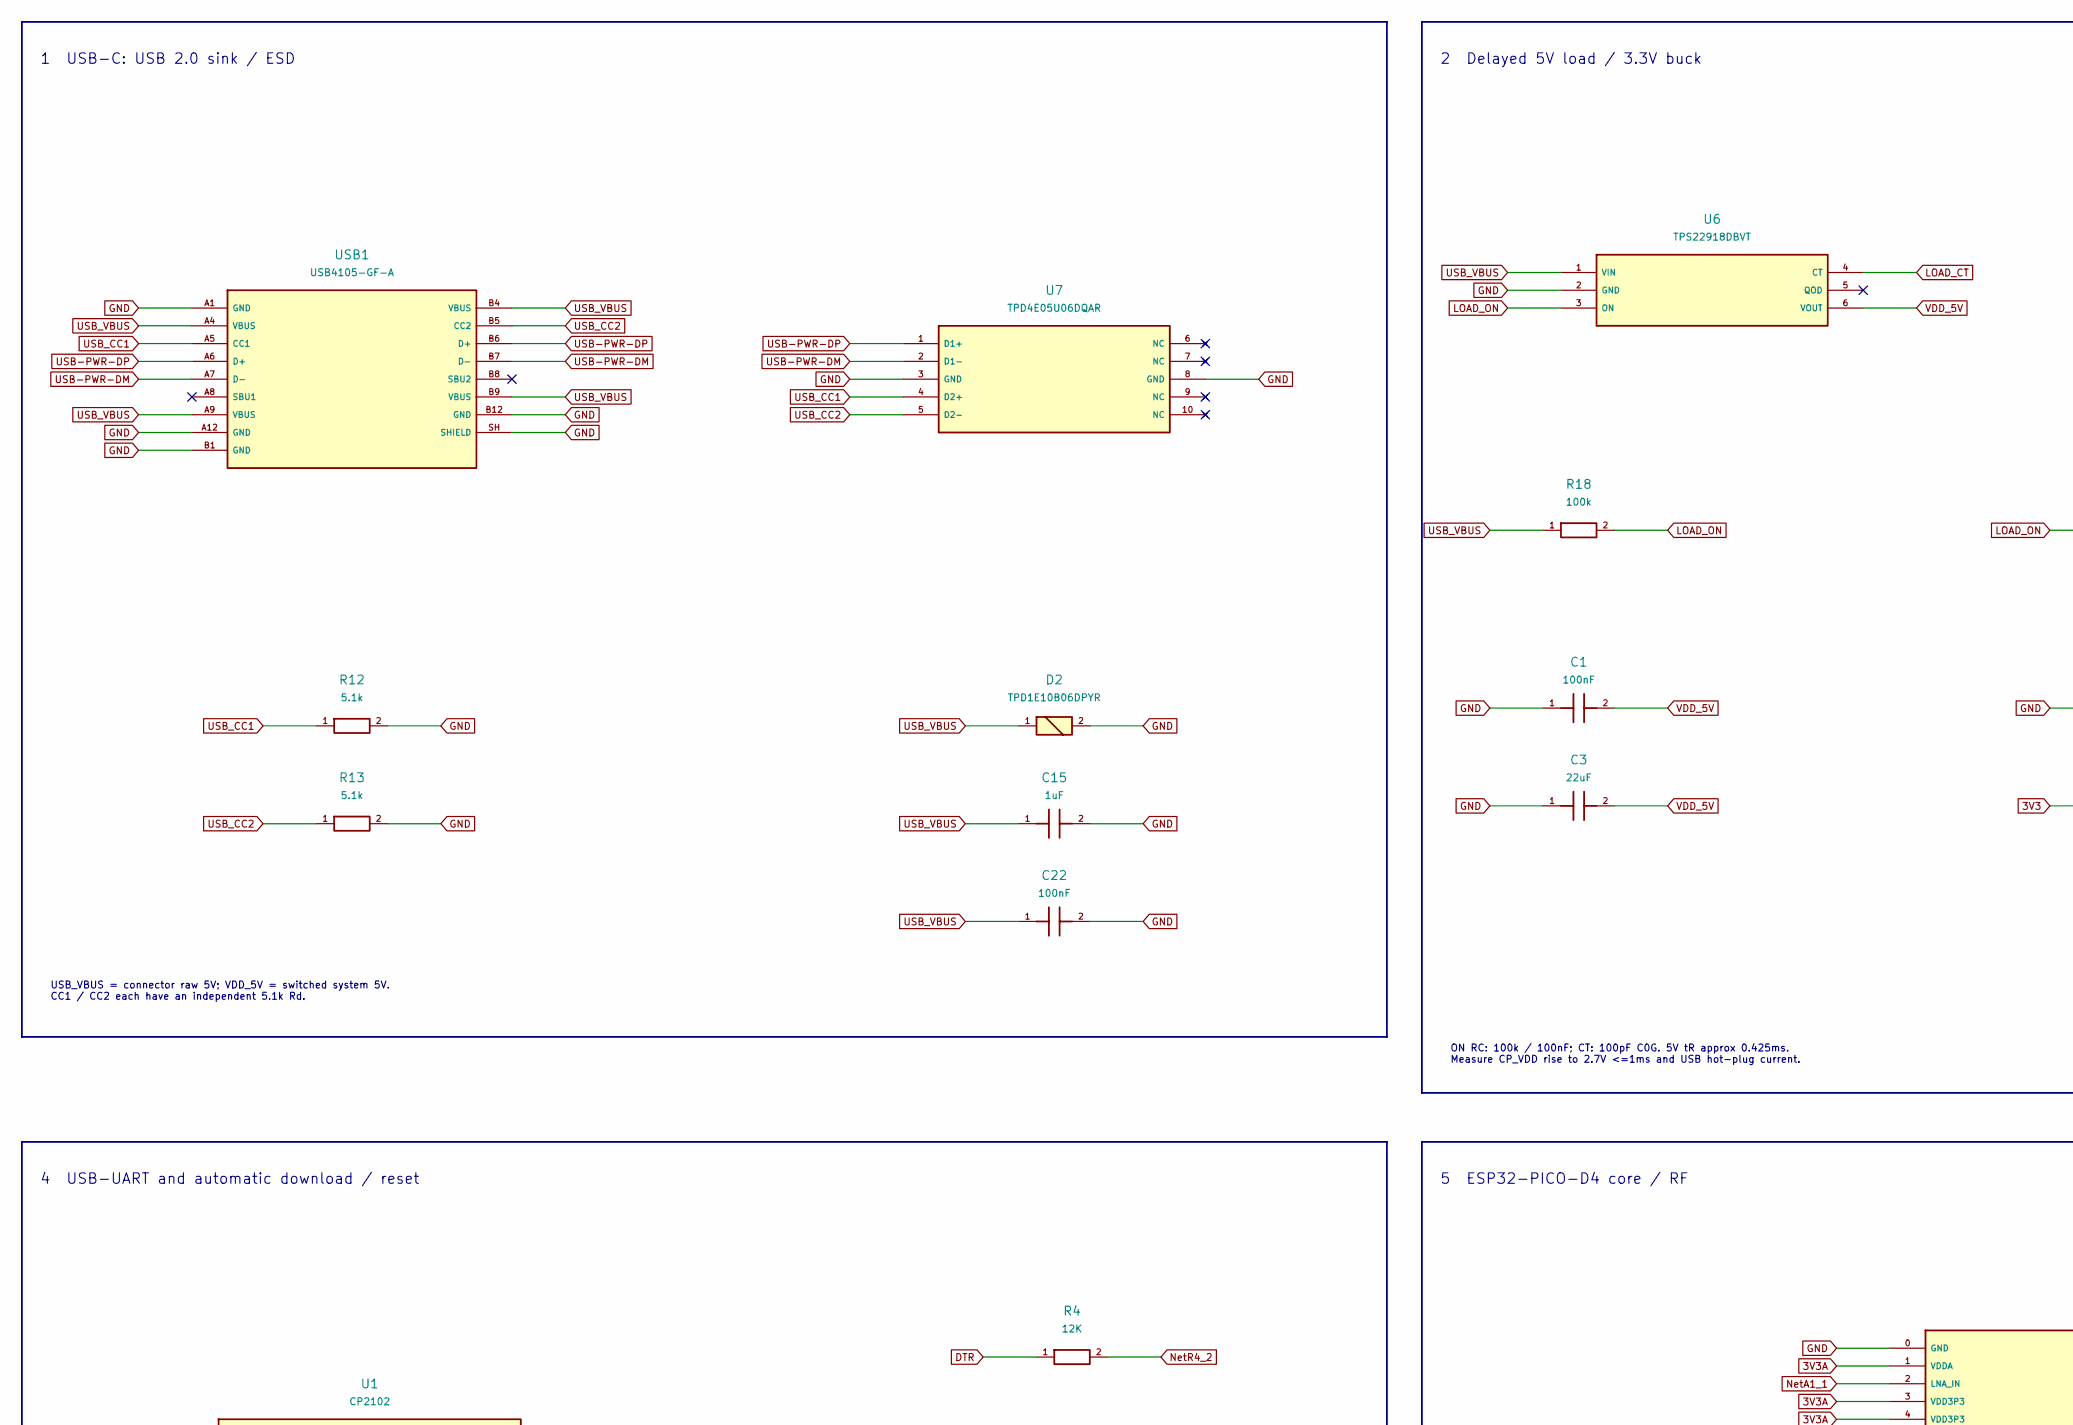
[picture p9: schematic MainBoard.kicad_sch, HoloCubic Naive RevB — Main board, part in row 1, column 1]

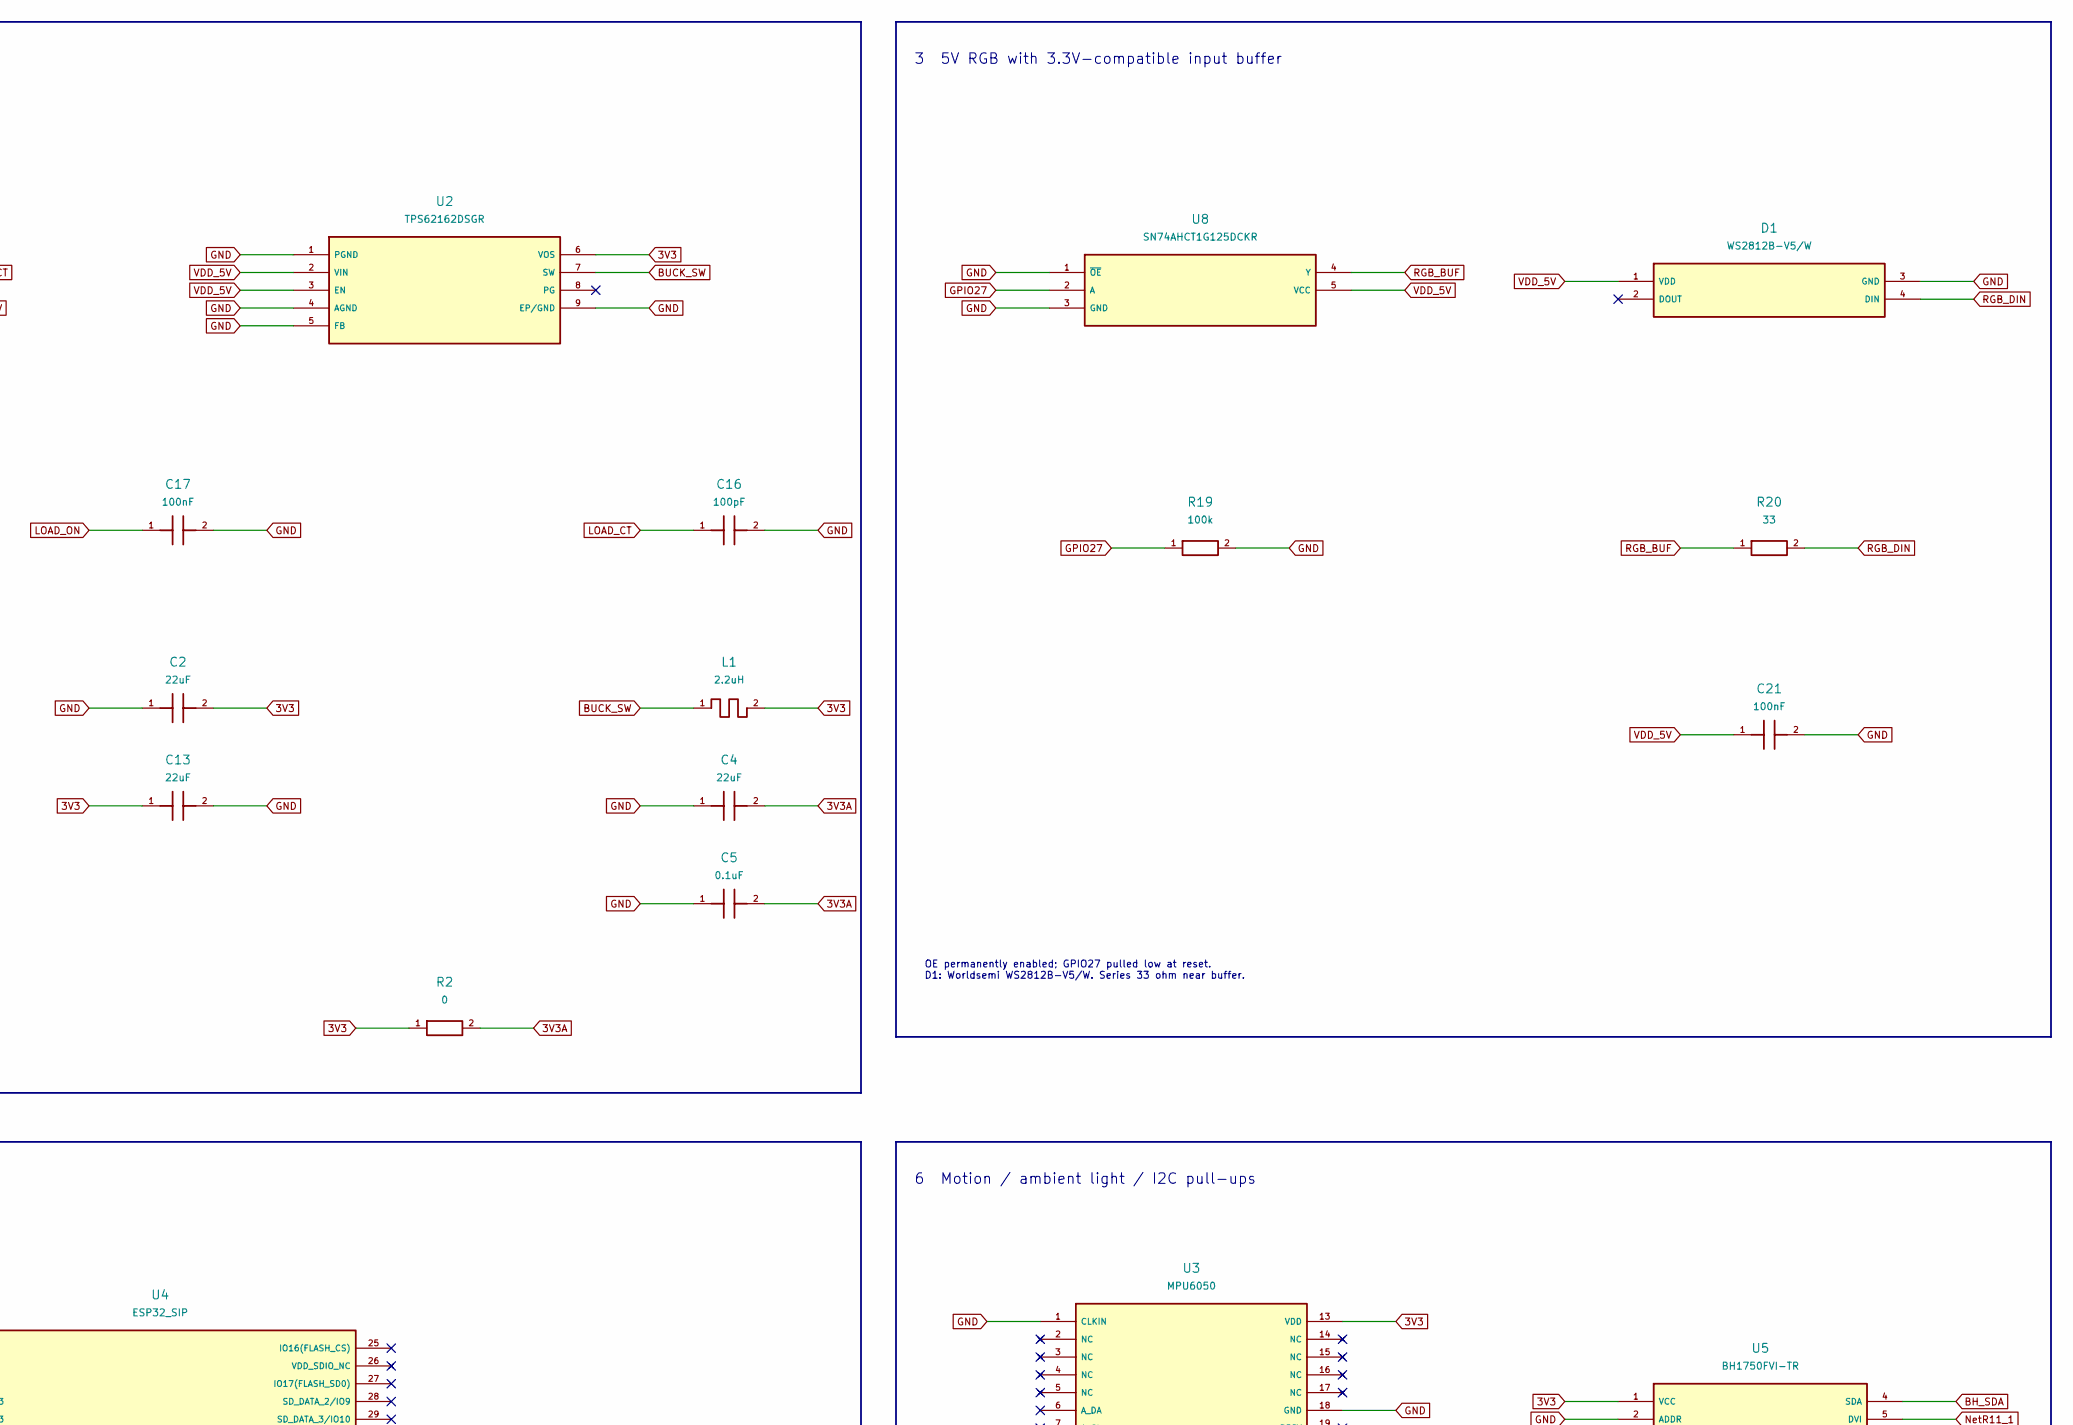
[picture p10: schematic MainBoard.kicad_sch, HoloCubic Naive RevB — Main board, part in row 1, column 2]

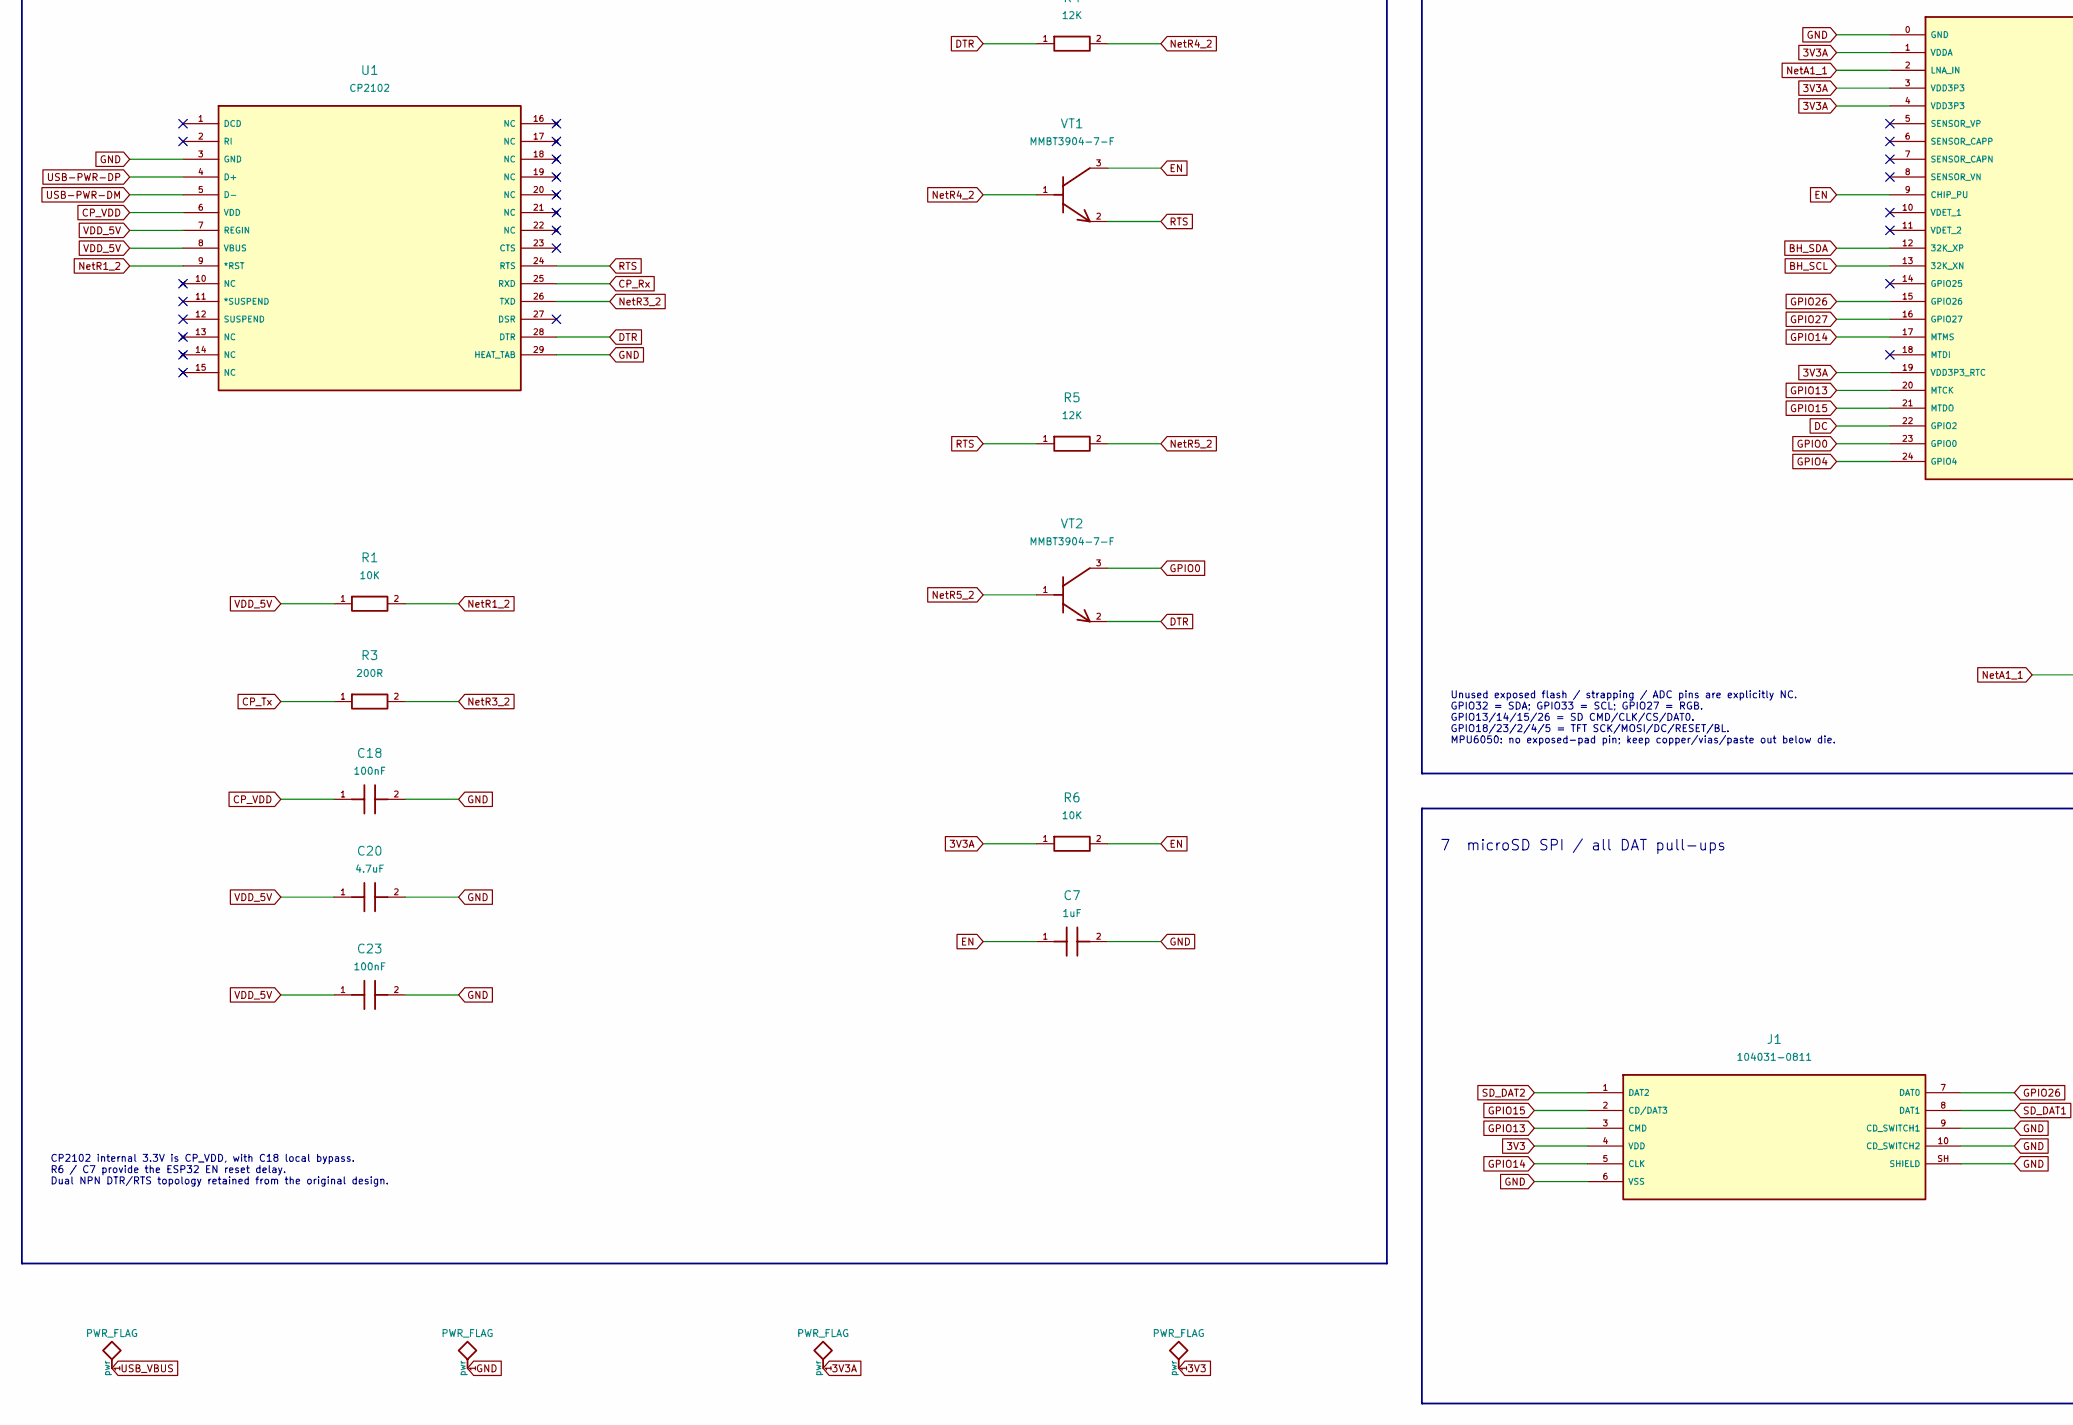
[picture p11: schematic MainBoard.kicad_sch, HoloCubic Naive RevB — Main board, part in row 2, column 1]

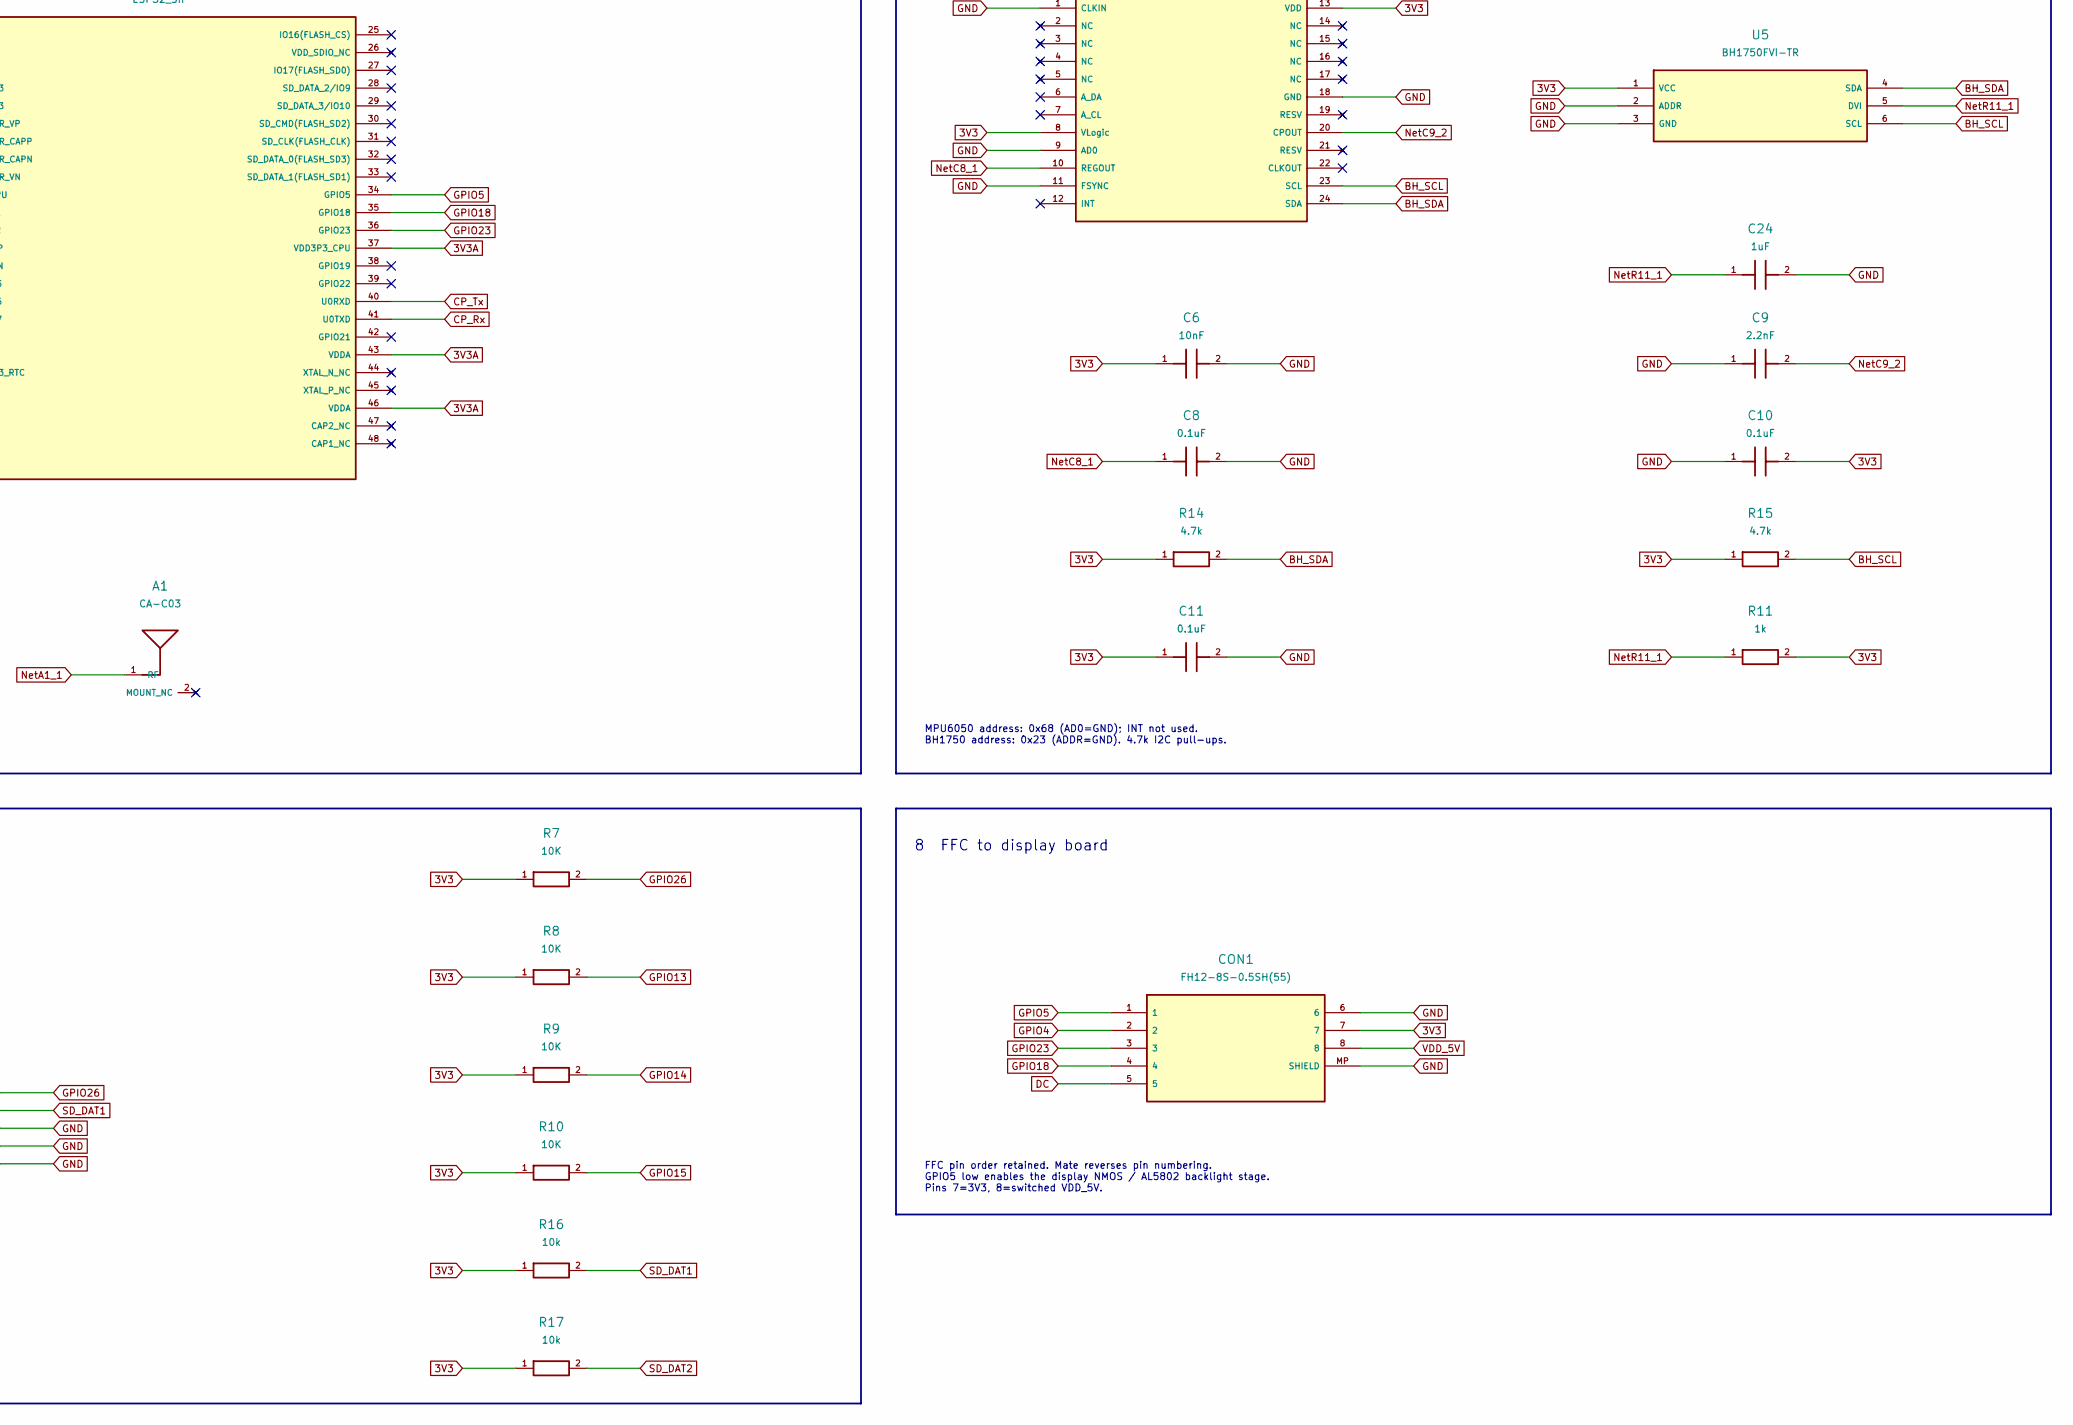
[picture p12: schematic MainBoard.kicad_sch, HoloCubic Naive RevB — Main board, part in row 2, column 2]

Parts:
A1: CA-C03; RevB_A1; MPN CA-C03
C1: 100nF; RevB_C1; MPN GRM155R71C104KA88D
C2: 22uF; RevB_C2; MPN GRM21BR61E226ME44L
C3: 22uF; RevB_C3; MPN GRM21BR61E226ME44L
C4: 22uF; RevB_C4; MPN GRM21BR61E226ME44L
C5: 0.1uF; Original_C5; MPN GRM155R71C104KA88D
C6: 10nF; Original_C6; MPN GRM155R71H103KA88D
C7: 1uF; RevB_C7; MPN GRM155R61C105KA12D
C8: 0.1uF; Original_C8; MPN GRM155R71C104KA88D
C9: 2.2nF; Original_C9; MPN GRM1555C1H222JA01D
C10: 0.1uF; Original_C10; MPN GRM155R71C104KA88D
C11: 0.1uF; Original_C11; MPN GRM155R71C104KA88D
C13: 22uF; RevB_C13; MPN GRM21BR61E226ME44L
C15: 1uF; RevB_C15; MPN GRM155R61C105KA12D
C16: 100pF; RevB_C16; MPN GRM1555C1H101JA01D
C17: 100nF; RevB_C17; MPN GRM155R71C104KA88D
C18: 100nF; RevB_C18; MPN GRM155R71C104KA88D
C20: 4.7uF; RevB_C20; MPN GRM155R61A475MEAAD
C21: 100nF; RevB_C21; MPN GRM155R71C104KA88D
C22: 100nF; RevB_C22; MPN GRM155R71C104KA88D
C23: 100nF; RevB_C23; MPN GRM155R71C104KA88D
C24: 1uF; RevB_C24; MPN GRM188R71E105KA12D
CON1: FH12-8S-0.5SH(55); RevB_CON1; MPN FH12-8S-0.5SH(55)
D1: WS2812B-V5/W; Original_D1; MPN WS2812B-V5/W
D2: TPD1E10B06DPYR; RevB_D2; MPN TPD1E10B06DPYR
J1: 104031-0811; RevB_J1; MPN 104031-0811
L1: 2.2uH; RevB_L1; MPN VLS3012HBX-2R2M-N
R1: 10K; Original_R1; MPN RC0402FR-0710KL
R2: 0; RevB_R2; MPN RC0402JR-070RL
R3: 200R; Original_R3; MPN RTT022000FTH
R4: 12K; Original_R4; MPN RC0402FR-0712KL
R5: 12K; Original_R5; MPN RC0402FR-0712KL
R6: 10K; Original_R6; MPN RC0402FR-0710KL
R7: 10K; Original_R7; MPN RC0402FR-0710KL
R8: 10K; Original_R8; MPN RC0402FR-0710KL
R9: 10K; Original_R9; MPN RC0402FR-0710KL
R10: 10K; Original_R10; MPN RC0402FR-0710KL
R11: 1k; RevB_R11; MPN RC0402FR-071KL
R12: 5.1k; RevB_R12; MPN RC0402FR-075K1L
R13: 5.1k; RevB_R13; MPN RC0402FR-075K1L
R14: 4.7k; RevB_R14; MPN RC0402FR-074K7L
R15: 4.7k; RevB_R15; MPN RC0402FR-074K7L
R16: 10k; RevB_R16; MPN RC0402FR-0710KL
R17: 10k; RevB_R17; MPN RC0402FR-0710KL
R18: 100k; RevB_R18; MPN RC0402FR-07100KL
R19: 100k; RevB_R19; MPN RC0402FR-07100KL
R20: 33; RevB_R20; MPN RC0402FR-0733RL
U1: CP2102; Original_U1; MPN CP2102-GMR
U2: TPS62162DSGR; RevB_U2; MPN TPS62162DSGR
U3: MPU6050; Original_U3; MPN MPU-6050
U4: ESP32_SIP; RevB_U4; MPN ESP32-PICO-D4
U5: BH1750FVI-TR; Original_U5; MPN BH1750FVI-TR
U6: TPS22918DBVT; RevB_U6; MPN TPS22918DBVT
U7: TPD4E05U06DQAR; RevB_U7; MPN TPD4E05U06DQAR
U8: SN74AHCT1G125DCKR; RevB_U8; MPN SN74AHCT1G125DCKR
USB1: USB4105-GF-A; RevB_USB1; MPN USB4105-GF-A
VT1: MMBT3904-7-F; RevB_VT1; MPN MMBT3904-7-F
VT2: MMBT3904-7-F; RevB_VT2; MPN MMBT3904-7-F

Connections:
3V3: C2.2, C6.1, C10.2, C11.1, C13.1, CON1.7, J1.4 (VDD), L1.2, R2.1, R7.1, R8.1, R9.1, R10.1, R11.2, R14.1, R15.1, R16.1, R17.1, U2.6 (VOS), U3.8 (VLogic), U3.13 (VDD), U5.1 (VCC)
3V3A: C4.2, C5.2, R2.2, R6.1, U4.1 (VDDA), U4.3 (VDD3P3), U4.4 (VDD3P3), U4.19 (VDD3P3_RTC), U4.37 (VDD3P3_CPU), U4.43 (VDDA), U4.46 (VDDA)
BH_SCL: R15.2, U3.23 (SCL), U4.13 (32K_XN), U5.6 (SCL)
BH_SDA: R14.2, U3.24 (SDA), U4.12 (32K_XP), U5.4 (SDA)
BUCK_SW: L1.1, U2.7 (SW)
CP_Rx: U1.25 (RXD), U4.41 (U0TXD)
CP_Tx: R3.1, U4.40 (U0RXD)
CP_VDD: C18.1, U1.6 (VDD)
DC: CON1.5, U4.22 (GPIO2)
DTR: R4.1, U1.28 (DTR), VT2.2
EN: C7.1, R6.2, U4.9 (CHIP_PU), VT1.3
GND: C1.1, C2.1, C3.1, C4.1, C5.1, C6.2, C7.2, C8.2, C9.1, C10.1, C11.2, C13.2, C15.2, C16.2, C17.2, C18.2, C20.2, C21.2, C22.2, C23.2, C24.2, CON1.6, CON1.MP (SHIELD), D1.3 (GND), D2.2, J1.6 (VSS), J1.9 (CD_SWITCH1), J1.10 (CD_SWITCH2), J1.SH (SHIELD), R12.2, R13.2, R19.2, U1.3 (GND), U1.29 (HEAT_TAB), U2.1 (PGND), U2.4 (AGND), U2.5 (FB), U2.9 (EP/GND), U3.1 (CLKIN), U3.9 (AD0), U3.11 (FSYNC), U3.18 (GND), U4.0 (GND), U5.2 (ADDR), U5.3 (GND), U6.2 (GND), U7.3 (GND), U7.8 (GND), U8.1 (~OE), U8.3 (GND), USB1.A1 (GND), USB1.A12 (GND), USB1.B1 (GND), USB1.B12 (GND), USB1.SH (SHIELD)
GPIO0: U4.23 (GPIO0), VT2.3
GPIO4: CON1.2, U4.24 (GPIO4)
GPIO5: CON1.1, U4.34 (GPIO5)
GPIO13: J1.3 (CMD), R8.2, U4.20 (MTCK)
GPIO14: J1.5 (CLK), R9.2, U4.17 (MTMS)
GPIO15: J1.2 (CD/DAT3), R10.2, U4.21 (MTDO)
GPIO18: CON1.4, U4.35 (GPIO18)
GPIO23: CON1.3, U4.36 (GPIO23)
GPIO26: J1.7 (DAT0), R7.2, U4.15 (GPIO26)
GPIO27: R19.1, U4.16 (GPIO27), U8.2 (A)
LOAD_CT: C16.1, U6.4 (CT)
LOAD_ON: C17.1, R18.2, U6.3 (ON)
NetA1_1: A1.1 (RF), U4.2 (LNA_IN)
NetC8_1: C8.1, U3.10 (REGOUT)
NetC9_2: C9.2, U3.20 (CPOUT)
NetR1_2: R1.2, U1.9 (*RST)
NetR3_2: R3.2, U1.26 (TXD)
NetR4_2: R4.2, VT1.1
NetR5_2: R5.2, VT2.1
NetR11_1: C24.1, R11.1, U5.5 (DVI)
RGB_BUF: R20.1, U8.4 (Y)
RGB_DIN: D1.4 (DIN), R20.2
RTS: R5.1, U1.24 (RTS), VT1.2
SD_DAT1: J1.8 (DAT1), R16.2
SD_DAT2: J1.1 (DAT2), R17.2
USB-PWR-DM: U1.5 (D-), U7.2 (D1-), USB1.A7 (D-), USB1.B7 (D-)
USB-PWR-DP: U1.4 (D+), U7.1 (D1+), USB1.A6 (D+), USB1.B6 (D+)
USB_CC1: R12.1, U7.4 (D2+), USB1.A5 (CC1)
USB_CC2: R13.1, U7.5 (D2-), USB1.B5 (CC2)
USB_VBUS: C15.1, C22.1, D2.1, R18.1, U6.1 (VIN), USB1.A4 (VBUS), USB1.A9 (VBUS), USB1.B4 (VBUS), USB1.B9 (VBUS)
VDD_5V: C1.2, C3.2, C20.1, C21.1, C23.1, CON1.8, D1.1 (VDD), R1.1, U1.7 (REGIN), U1.8 (VBUS), U2.2 (VIN), U2.3 (EN), U6.6 (VOUT), U8.5 (VCC)

Notes on the sheet:
1 USB-C: USB 2.0 sink / ESD
2 Delayed 5V load / 3.3V buck
3 5V RGB with 3.3V-compatible input buffer
4 USB-UART and automatic download / reset
5 ESP32-PICO-D4 core / RF
6 Motion / ambient light / I2C pull-ups
7 microSD SPI / all DAT pull-ups
8 FFC to display board
USB_VBUS = connector raw 5V; VDD_5V = switched system 5V. CC1 / CC2 each have an independent 5.1k Rd.
ON RC: 100k / 100nF; CT: 100pF C0G. 5V tR approx 0.425ms. Measure CP_VDD rise to 2.7V <=1ms and USB hot-plug current.
OE permanently enabled; GPIO27 pulled low at reset. D1: Worldsemi WS2812B-V5/W. Series 33 ohm near buffer.
CP2102 internal 3.3V is CP_VDD, with C18 local bypass. R6 / C7 provide the ESP32 EN reset delay. Dual NPN DTR/RTS topology retained from the original design.
Unused exposed flash / strapping / ADC pins are explicitly NC. GPIO32 = SDA; GPIO33 = SCL; GPIO27 = RGB. GPIO13/14/15/26 = SD CMD/CLK/CS/DAT0. GPIO18/23/2/4/5 = TFT SCK/MOSI/DC/RESET/BL. MPU6050: no exposed-pad pin; keep copper/vias/paste out below die.
MPU6050 address: 0x68 (AD0=GND); INT not used. BH1750 address: 0x23 (ADDR=GND). 4.7k I2C pull-ups.
FFC pin order retained. Mate reverses pin numbering. GPIO5 low enables the display NMOS / AL5802 backlight stage. Pins 7=3V3, 8=switched VDD_5V.

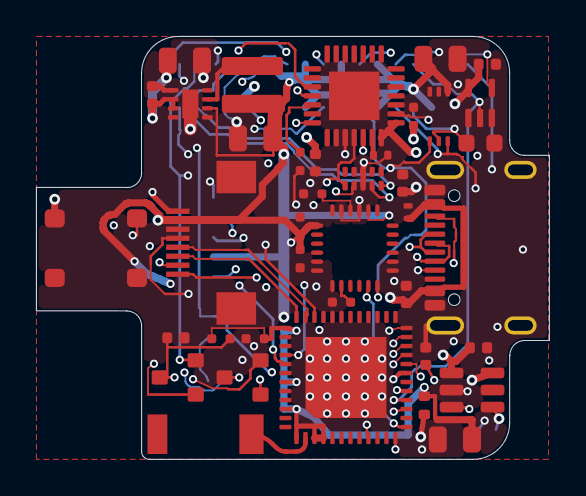
[picture p13: board MainBoard.kicad_pcb from above]

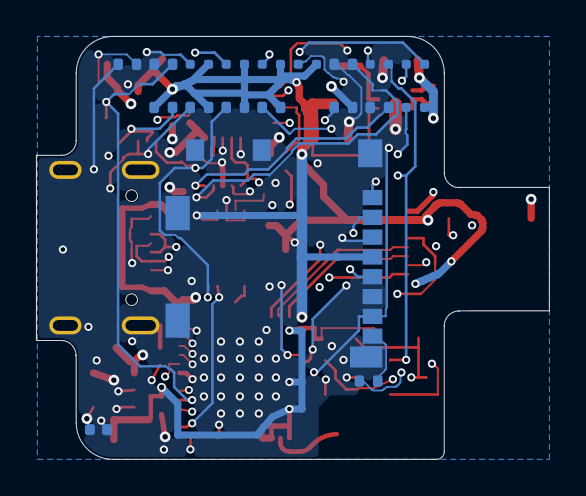
[picture p14: board MainBoard.kicad_pcb from below]

Board: 6 copper layers, 28.5 x 23.5 mm, 58 parts (19 on the bottom side), 43 nets.
