guido233/HoloCubic/1.Hardware/RevB-KiCad/Naive/ExtendBoard/ExtendBoard.kicad_pcb

## KiCad design 1.Hardware/RevB-KiCad/Naive/ExtendBoard/ExtendBoard.kicad_pcb (2026-10-30)

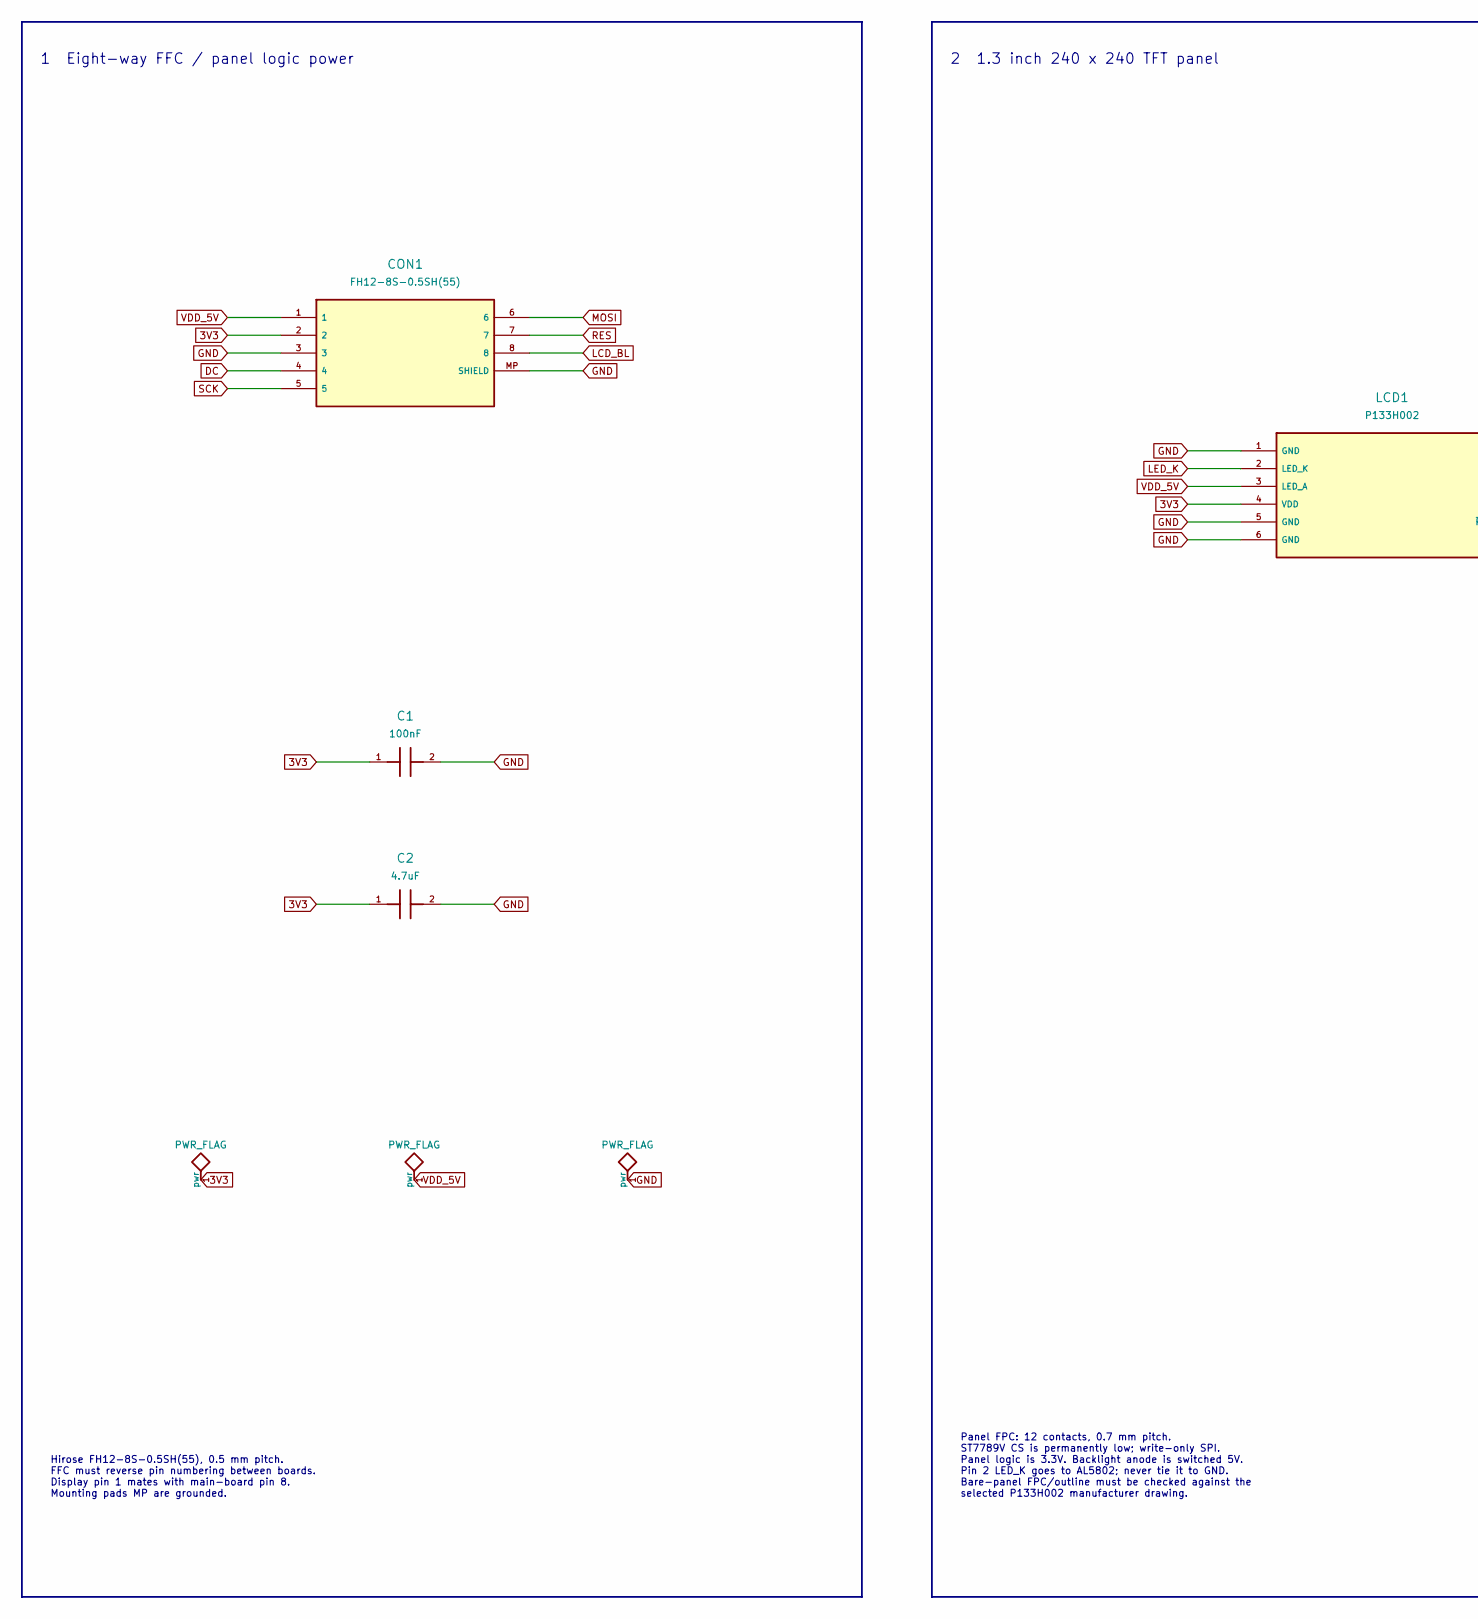
[picture p15: schematic ExtendBoard.kicad_sch, HoloCubic Naive RevB — Display board, part in row 1, column 1]

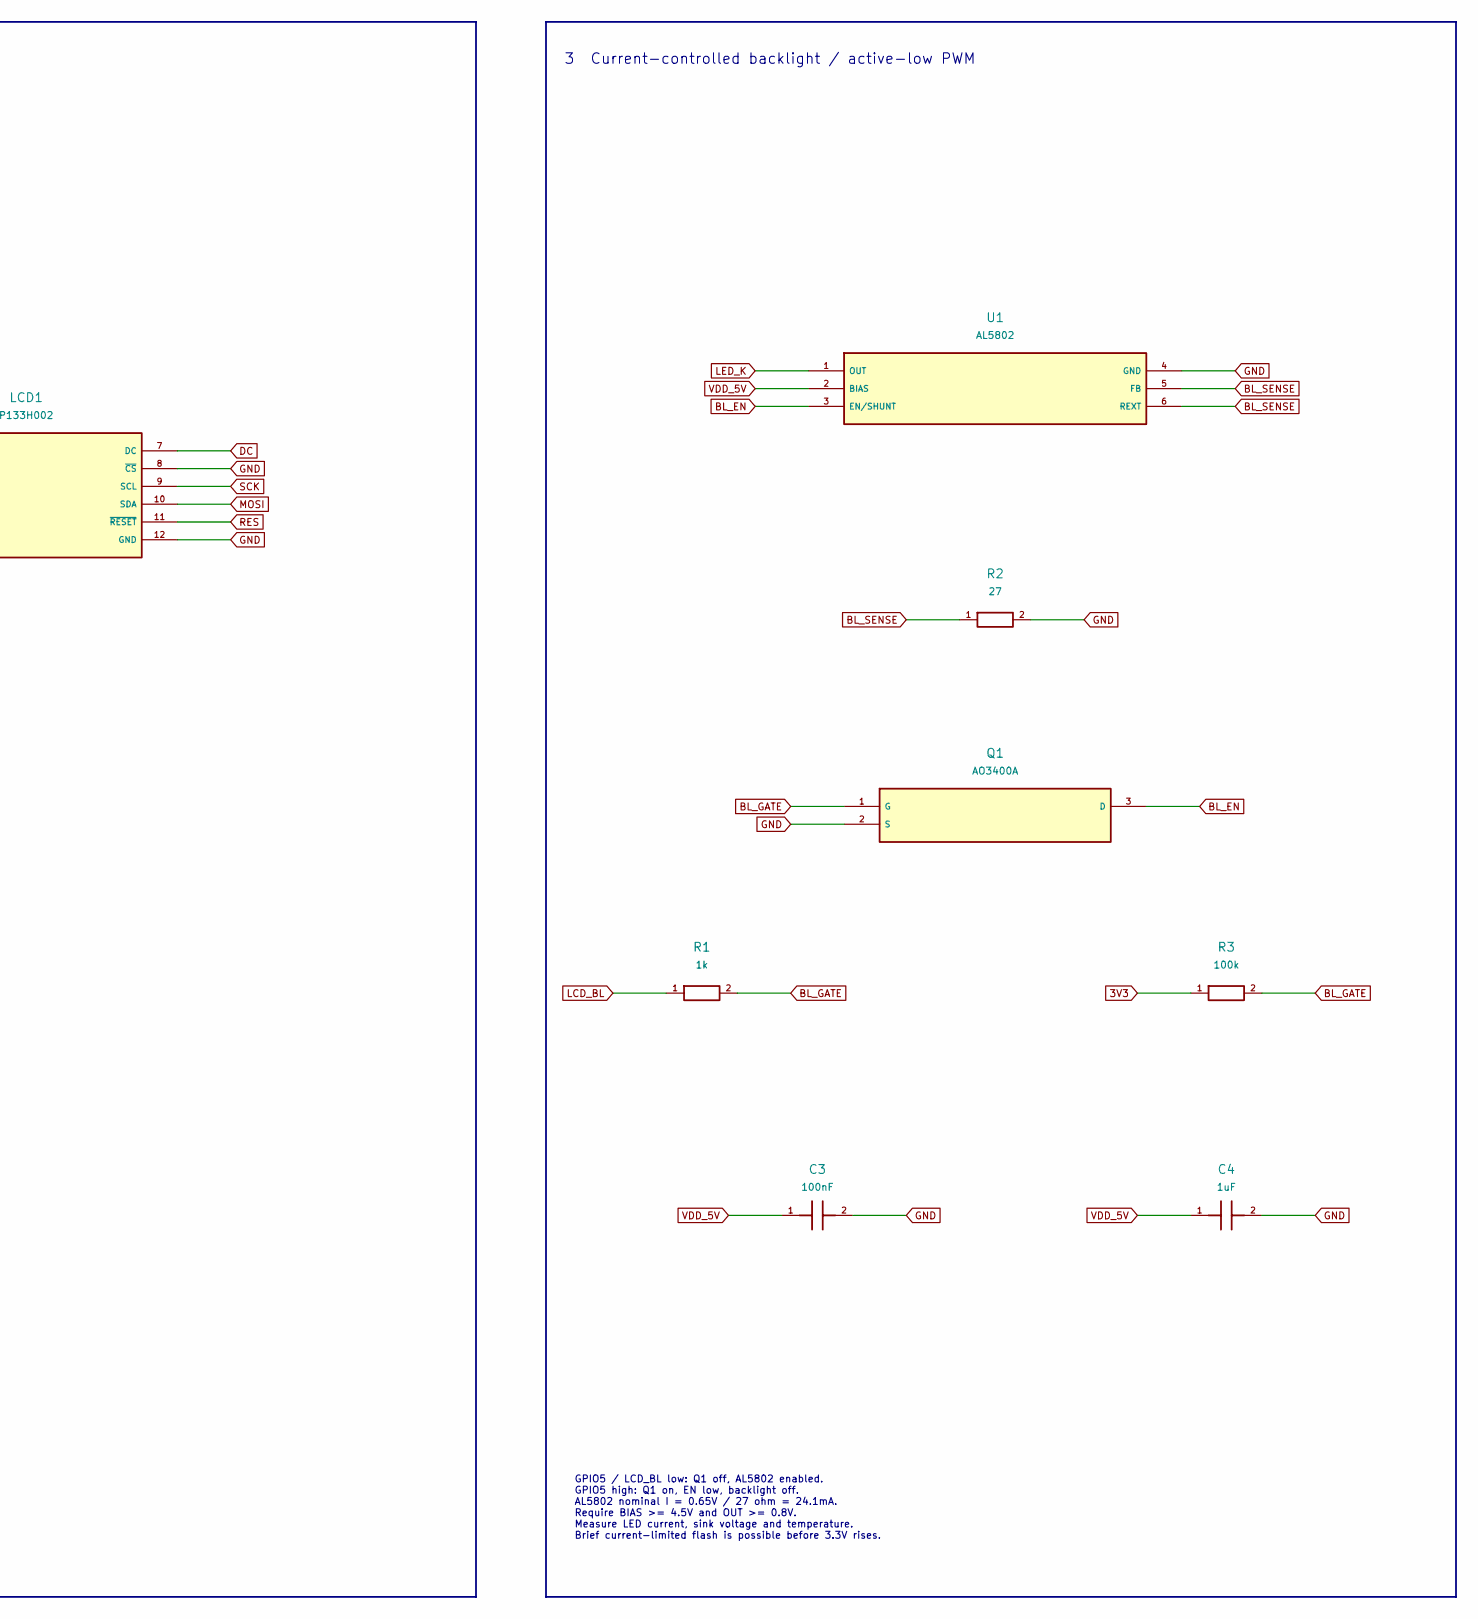
[picture p16: schematic ExtendBoard.kicad_sch, HoloCubic Naive RevB — Display board, part in row 1, column 2]

Parts:
C1, C3: 100nF; C_0402; MPN GRM155R71C104KA88D
C2: 4.7uF; C_0603; MPN GRM188R61A475KE15D
C4: 1uF; C_0603; MPN GRM188R71E105KA12D
CON1: FH12-8S-0.5SH(55); FFC_8P_0.5mm; MPN FH12-8S-0.5SH(55)
LCD1: P133H002; LCD_12P_0.7mm; MPN P133H002
Q1: AO3400A; SOT23_NMOS; MPN AO3400A
R1: 1k; R_0402; MPN RC0402FR-071KL
R2: 27; R_0603; MPN RC0603FR-0727RL
R3: 100k; R_0402; MPN RC0402FR-07100KL
U1: AL5802; SOT26_AL5802; MPN AL5802-7

Connections:
3V3: C1.1, C2.1, CON1.2, LCD1.4 (VDD), R3.1
BL_EN: Q1.3 (D), U1.3 (EN/SHUNT)
BL_GATE: Q1.1 (G), R1.2, R3.2
BL_SENSE: R2.1, U1.5 (FB), U1.6 (REXT)
DC: CON1.4, LCD1.7 (DC)
GND: C1.2, C2.2, C3.2, C4.2, CON1.3, CON1.MP (SHIELD), LCD1.1 (GND), LCD1.5 (GND), LCD1.6 (GND), LCD1.8 (~CS), LCD1.12 (GND), Q1.2 (S), R2.2, U1.4 (GND)
LCD_BL: CON1.8, R1.1
LED_K: LCD1.2 (LED_K), U1.1 (OUT)
MOSI: CON1.6, LCD1.10 (SDA)
RES: CON1.7, LCD1.11 (~RESET)
SCK: CON1.5, LCD1.9 (SCL)
VDD_5V: C3.1, C4.1, CON1.1, LCD1.3 (LED_A), U1.2 (BIAS)

Notes on the sheet:
1 Eight-way FFC / panel logic power
2 1.3 inch 240 x 240 TFT panel
3 Current-controlled backlight / active-low PWM
Hirose FH12-8S-0.5SH(55), 0.5 mm pitch. FFC must reverse pin numbering between boards. Display pin 1 mates with main-board pin 8. Mounting pads MP are grounded.
Panel FPC: 12 contacts, 0.7 mm pitch. ST7789V CS is permanently low; write-only SPI. Panel logic is 3.3V. Backlight anode is switched 5V. Pin 2 LED_K goes to AL5802; never tie it to GND. Bare-panel FPC/outline must be checked against the selected P133H002 manufacturer drawing.
GPIO5 / LCD_BL low: Q1 off, AL5802 enabled. GPIO5 high: Q1 on, EN low, backlight off. AL5802 nominal I = 0.65V / 27 ohm = 24.1mA. Require BIAS >= 4.5V and OUT >= 0.8V. Measure LED current, sink voltage and temperature. Brief current-limited flash is possible before 3.3V rises.

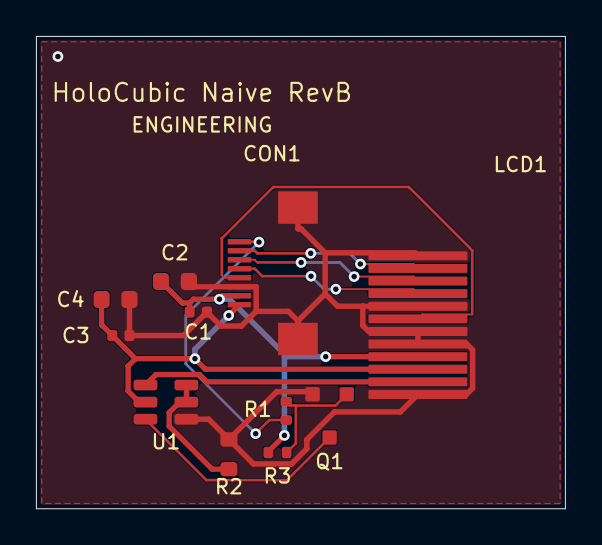
[picture p17: board ExtendBoard.kicad_pcb from above]

Board: 2 copper layers, 29.4 x 26.2 mm, 11 parts (1 on the bottom side), 12 nets.
