guido233/HoloCubic/tools/hardware/verify_hardware.py

#!/usr/bin/env python3
"""Static validation of HoloCubic RevB native KiCad sources.

Exports fresh native netlists and runs native ERC; compares real schematic/PCB
node partitions, checks intentionally selected electrical invariants and the MPU
paste/keepout geometry. These are design checks, not physical measurements,
USB compliance, current-limit, thermal, RF, or power-up timing certification.

Run after source edits (KiCad 10 CLI required):
  python3 tools/hardware/verify_hardware.py --main-only --output report.json
  python3 tools/hardware/verify_hardware.py --output report.json
Optional --drc also records native DRC including schematic parity. Nothing in a
schematic, PCB, project, or installed app is modified by this script.
"""
import argparse, json, math, os, re, shutil, subprocess, tempfile
from collections import defaultdict
from pathlib import Path
import xml.etree.ElementTree as ET
from revise_schematic import parse, get, alln, prop

ROOT=Path(__file__).resolve().parents[2]
DEFAULT_CLI=Path(shutil.which('kicad-cli') or next((str(p) for p in [
    Path('/Applications/KiCad/KiCad.app/Contents/MacOS/kicad-cli'),
    Path('/Applications/KiCad.app/Contents/MacOS/kicad-cli'),
    Path.home()/'Applications/KiCad/KiCad.app/Contents/MacOS/kicad-cli'
] if p.exists()), 'kicad-cli'))

class Checks:
    def __init__(self): self.rows=[]
    def add(self,name,ok,detail=None):
        self.rows.append({'check':name,'passed':bool(ok),'detail':detail})
        return bool(ok)
    def same(self,d,name,*nodes):
        nets=[d.pins.get(tuple(n)) for n in nodes]
        return self.add(name,all(nets) and len(set(nets))==1,{'nodes':nodes,'nets':nets})
    def apart(self,d,name,*nodes):
        nets=[d.pins.get(tuple(n)) for n in nodes]
        return self.add(name,all(nets) and len(set(nets))==len(nets),{'nodes':nodes,'nets':nets})
    def value(self,d,ref,want):
        actual=d.values.get(ref)
        return self.add(ref+' value',value(actual)==value(want),{'expected':want,'actual':actual})

def value(s):
    if s is None:return None
    s=s.strip().lower().replace('ω','').replace('ohm','').replace('f','').replace('h','')
    m=re.fullmatch(r'(\d+(?:\.\d+)?)([rkmungp]?)',s)
    if not m:return s
    return float(m[1])*{'':1,'r':1,'k':1e3,'m':1e6,'u':1e-6,'n':1e-9,'p':1e-12,'g':1e9}[m[2]]

class Circuit:
    def __init__(self): self.pins={};self.groups=defaultdict(set);self.values={};self.footprints={};self.paths={};self.mpns={}
    def add(self,ref,no,net):
        node=(str(ref),str(no))
        if net:self.pins[node]=str(net);self.groups[str(net)].add(node)
    def net(self,ref,no):return self.pins.get((ref,str(no)))
    def nodes(self,ref,no):return self.groups.get(self.net(ref,no),set())

def schematic_netlist(path):
    r=ET.parse(path).getroot();d=Circuit()
    for c in r.findall('components/comp'):
        ref=c.attrib['ref'];d.values[ref]=c.findtext('value');d.footprints[ref]=c.findtext('footprint')
        d.mpns[ref]=next((f.text or '' for f in c.findall('fields/field') if f.attrib.get('name')=='MPN'),'')
    for n in r.findall('nets/net'):
        for pin in n.findall('node'):
            if not pin.attrib['ref'].startswith('#'):d.add(pin.attrib['ref'],pin.attrib['pin'],n.attrib['name'])
    return d

def pcb_circuit(path):
    r=parse(Path(path).read_text());d=Circuit();fps={}
    for f in alln(r,'footprint'):
        p=prop(f,'Reference')
        if not p:continue
        ref=str(p[2]);fps[ref]=f;d.values[ref]=str(prop(f,'Value')[2]);d.footprints[ref]=str(f[1]);d.paths[ref]=get(f,'path',['path',''])[1]
        d.mpns[ref]=str((prop(f,'MPN') or ['property','MPN',''])[2])
        for pad in alln(f,'pad'):
            if pad[1]:
                net=get(pad,'net');d.add(ref,pad[1],net[-1] if net else '__NC_%s_%s'%(ref,pad[1]))
    return d,r,fps

def parity(c,sc,pcb,schpath):
    c.add('Schematic and PCB component references',set(sc.values)==set(pcb.values),{'schematic_only':sorted(set(sc.values)-set(pcb.values)),'pcb_only':sorted(set(pcb.values)-set(sc.values))})
    diffs=[]
    for node in set(sc.pins)|set(pcb.pins):
        # A one-pad unused net may legitimately have a source name or KiCad's
        # autogenerated unconnected name. A missing pad never counts as equal.
        if node not in pcb.pins or node not in sc.pins:diffs.append({'node':node,'reason':'missing pad/node'});continue
        sn=sc.nodes(*node);pn=pcb.nodes(*node)
        if sn!=pn:diffs.append({'node':node,'schematic':sorted(sn),'pcb':sorted(pn)})
    c.add('Schematic/PCB electrical node partitions',not diffs,diffs)
    nd=[]
    for node,snet in sc.pins.items():
        pnet=pcb.pins.get(node)
        if not snet.startswith('unconnected-') and snet!=pnet:nd.append({'node':node,'schematic':snet,'pcb':pnet})
    c.add('Schematic/PCB functional net names exactly match',not nd,nd)
    vd=[];fd=[]
    for ref in set(sc.values)&set(pcb.values):
        if value(sc.values[ref])!=value(pcb.values[ref]):vd.append({'ref':ref,'schematic':sc.values[ref],'pcb':pcb.values[ref]})
        if sc.footprints[ref]!=pcb.footprints[ref]:fd.append({'ref':ref,'schematic':sc.footprints[ref],'pcb':pcb.footprints[ref]})
    c.add('Schematic/PCB values',not vd,vd);c.add('Schematic/PCB footprint links',not fd,fd)
    md=[{'ref':ref,'schematic':sc.mpns.get(ref),'pcb':pcb.mpns.get(ref)} for ref in set(sc.values)&set(pcb.values)
        if not sc.mpns.get(ref) or sc.mpns.get(ref)!=pcb.mpns.get(ref)]
    c.add('Schematic/PCB exact MPN fields',not md,md)
    sch=parse(Path(schpath).read_text());rootid=get(sch,'uuid')[1];pd=[]
    for s in alln(sch,'symbol'):
        ref=str(prop(s,'Reference')[2])
        if ref.startswith('#'):continue
        expected='/'+str(rootid)+'/'+str(get(s,'uuid')[1]);actual=pcb.paths.get(ref)
        if actual!=expected:pd.append({'ref':ref,'expected':expected,'actual':actual})
    c.add('PCB paths match schematic root/symbol UUIDs',not pd,pd)

def main_electrical(c,d):
    N=lambda ref,no:(ref,str(no))
    # USB-C has independent Rd on each CC. No connector raw VBUS is conflated
    # with the switched system supply or either 3.3V domain.
    c.same(d,'CC1 independent Rd',N('USB1','A5'),N('R12',1),N('U7',4))
    c.same(d,'CC2 independent Rd',N('USB1','B5'),N('R13',1),N('U7',5))
    c.apart(d,'CC1/CC2/raw VBUS independent',N('R12',1),N('R13',1),N('USB1','A4'),N('U4',0))
    c.same(d,'CC Rd to GND',N('R12',2),N('R13',2),N('U4',0))
    c.value(d,'R12','5.1k');c.value(d,'R13','5.1k')
    c.same(d,'All four USB VBUS contacts raw',*[N('USB1',p) for p in ['A4','A9','B4','B9']],N('U6',1),N('D2',1))
    c.same(d,'USB ground contacts and shell grounded',*[N('USB1',p) for p in ['A1','A12','B1','B12','SH']],N('U4',0))
    c.same(d,'Both TPD4E05U06 ground terminals connected',N('U7',3),N('U7',8),N('U4',0))
    c.apart(d,'Raw 5V / switched 5V / 3V3 / MCU 3V3 isolated by parts',N('U6',1),N('U6',6),N('U2',6),N('U4',1),N('U4',0))
    c.same(d,'USB DP protection and UART bridge',N('USB1','A6'),N('USB1','B6'),N('U7',1),N('U1',4))
    c.same(d,'USB DM protection and UART bridge',N('USB1','A7'),N('USB1','B7'),N('U7',2),N('U1',5))
    c.apart(d,'USB DP / DM / CC1 / CC2 / raw VBUS / GND separate',N('U1',4),N('U1',5),N('USB1','A5'),N('USB1','B5'),N('U6',1),N('U4',0))
    # The CP2102 internal regulator must not backfeed the external buck output.
    c.same(d,'CP2102 internal VDD local bypass',N('U1',6),N('C18',1))
    c.apart(d,'CP internal VDD / external 3V3 / system 5V distinct',N('U1',6),N('U2',6),N('U6',6))
    c.add('CP VDD only feeds local decoupling',d.nodes('U1',6)=={N('U1',6),N('C18',1)},sorted(d.nodes('U1',6)))
    c.value(d,'C18','100nF')
    c.same(d,'CP2102 REGIN local bypass rail',N('U1',7),N('U1',8),N('C20',1),N('C23',1),N('U6',6))
    c.same(d,'CP2102 REGIN bypass ground',N('C20',2),N('C23',2),N('U4',0))
    c.value(d,'C20','4.7uF');c.value(d,'C23','100nF')
    # Fixed-output TPS62162 pinout: FB grounded; VOS senses after L1.
    c.same(d,'Buck supply and enable from switched 5V',N('U2',2),N('U2',3),N('U6',6))
    c.same(d,'Buck SW only into inductor',N('U2',7),N('L1',1))
    c.add('Buck switch net exactly two nodes',d.nodes('U2',7)=={N('U2',7),N('L1',1)},sorted(d.nodes('U2',7)))
    c.same(d,'Buck VOS senses output after L1',N('U2',6),N('L1',2),N('R2',1))
    c.same(d,'Fixed buck FB / AGND / PGND / EP grounded',*[N('U2',p) for p in [1,4,5,9]],N('U4',0))
    c.value(d,'L1','2.2uH');c.value(d,'R2','0')
    c.same(d,'All seven MCU supply terminals on 3V3A',*[N('U4',p) for p in [1,3,4,19,37,43,46]],N('R2',2),N('C5',2))
    c.same(d,'Load switch ON delay',N('U6',3),N('R18',2),N('C17',1));c.same(d,'Load switch timing capacitor',N('U6',4),N('C16',1))
    c.value(d,'R18','100k');c.value(d,'C17','100nF');c.value(d,'C16','100pF')
    c.add('Load switch CT exact C0G MPN',d.mpns.get('C16')=='GRM1555C1H101JA01D',d.mpns.get('C16'))
    c.add('Load switch selected DBVT MPN',d.mpns.get('U6')=='TPS22918DBVT',d.mpns.get('U6'))
    for ref,pin,rail in [('C3',2,N('U6',6)),('C2',2,N('U2',6)),('C13',1,N('U2',6)),('C4',2,N('U4',1))]:
        c.same(d,ref+' bulk capacitor rail',N(ref,pin),rail);c.same(d,ref+' bulk capacitor return',N(ref,3-pin),N('U4',0));c.value(d,ref,'22uF')
    # AHCT is powered from 5V; it separates MCU 3.3V output and RGB 5V DIN.
    c.same(d,'RGB MCU input / reset pull-down',N('U4',16),N('U8',2),N('R19',1))
    c.same(d,'RGB buffer output to series resistor',N('U8',4),N('R20',1))
    c.same(d,'RGB DIN after resistor',N('R20',2),N('D1',4))
    c.apart(d,'RGB GPIO / buffer output / lamp DIN separate',N('U8',2),N('U8',4),N('D1',4),N('U8',5),N('U4',0))
    c.same(d,'AHCT/WS2812 powered by switched 5V',N('U8',5),N('D1',1),N('U6',6))
    c.same(d,'AHCT enabled and RGB pull-down grounded',N('U8',1),N('U8',3),N('R19',2),N('U4',0))
    c.value(d,'R19','100k');c.value(d,'R20','33')
    # All SD data pins have 10k pull-ups, including unused DAT1/DAT2 in SPI.
    for pin,r in [('7','R7'),('3','R8'),('2','R10'),('8','R16'),('1','R17')]:
        c.same(d,'SD pin '+pin+' pull-up',N('J1',pin),N(r,2));c.same(d,r+' to card VCC',N(r,1),N('J1',4));c.value(d,r,'10k')
    c.apart(d,'All eight SD contacts are distinct nets',*[N('J1',p) for p in range(1,9)])
    for pin,mcu,label in [(5,17,'SCK GPIO14'),(3,20,'MOSI GPIO13'),(7,15,'MISO GPIO26'),(2,21,'CS GPIO15')]:
        c.same(d,'SD firmware mapping '+label,N('J1',pin),N('U4',mcu))
    c.add('GPIO12 flash-voltage strap remains unused',d.nodes('U4',18)=={N('U4',18)},sorted(d.nodes('U4',18)))
    c.same(d,'Molex shell and unused card-detect terminals grounded',N('J1','SH'),N('J1',9),N('J1',10),N('J1',6),N('U4',0))
    c.add('CA-C03 mechanical terminal is a single unused node',
          d.nodes('A1',2)=={N('A1',2)} and d.net('A1',2) is not None,
          sorted(d.nodes('A1',2)))
    c.same(d,'CA-C03 feed preserves MCU RF connection',N('A1',1),N('U4',2))
    c.apart(d,'Antenna feed / mechanical terminal / ground separate',N('A1',1),N('A1',2),N('U4',0))
    # External I2C pulls and preserved peripheral mapping.
    c.same(d,'I2C SDA: MCU32 / MPU / ALS / pull-up',N('U4',12),N('U3',24),N('U5',4),N('R14',2))
    c.same(d,'I2C SCL: MCU33 / MPU / ALS / pull-up',N('U4',13),N('U3',23),N('U5',6),N('R15',2))
    c.same(d,'I2C pulls to 3V3',N('R14',1),N('R15',1),N('U3',13));c.value(d,'R14','4.7k');c.value(d,'R15','4.7k')
    c.apart(d,'I2C SDA / SCL / VCC / GND separate',N('U3',24),N('U3',23),N('U3',13),N('U4',0))
    c.same(d,'MPU VDD and VLOGIC on 3V3',N('U3',8),N('U3',13),N('U2',6))
    c.same(d,'MPU address, FSYNC and ground grounded',*[N('U3',p) for p in [1,9,11,18]],N('U4',0))
    c.same(d,'BH1750 supply and ground',N('U5',1),N('U2',6));c.same(d,'BH1750 low address / ground',N('U5',2),N('U5',3),N('U4',0))
    c.apart(d,'BH DVI isolated from VCC by R11',N('U5',5),N('U5',1))
    c.same(d,'BH DVI resistor from VCC',N('R11',2),N('U5',1))
    c.same(d,'BH1750 DVI RC delay',N('U5',5),N('R11',1),N('C24',1));c.same(d,'BH DVI capacitor grounded',N('C24',2),N('U4',0));c.value(d,'R11','1k');c.value(d,'C24','1uF')
    c.add('BH1750 DVI selected 25V MPN',d.mpns.get('C24')=='GRM188R71E105KA12D',d.mpns.get('C24'))
    c.same(d,'EN capacitance on MCU enable',N('U4',9),N('R6',2),N('C7',1),N('VT1',3));c.value(d,'C7','1uF')
    c.same(d,'EN RC supply / ground',N('R6',1),N('U4',1));c.same(d,'EN capacitor return',N('C7',2),N('U4',0))
    c.apart(d,'EN / GPIO0 / MCU supply / GND distinct',N('U4',9),N('U4',23),N('U4',1),N('U4',0))
    c.same(d,'Auto download GPIO0 collector',N('VT2',3),N('U4',23));c.same(d,'DTR to transistor E2/base1 resistor',N('U1',28),N('VT2',2),N('R4',1));c.same(d,'RTS to transistor E1/base2 resistor',N('U1',24),N('VT1',2),N('R5',1))
    c.same(d,'UART CP TX through series resistor',N('U1',26),N('R3',2))
    c.same(d,'UART series resistor to MCU RX',N('R3',1),N('U4',40));c.value(d,'R3','200')
    c.add('UART series resistor selected RALEC MPN',d.mpns.get('R3')=='RTT022000FTH',d.mpns.get('R3'))
    c.same(d,'UART MCU TX to CP RX',N('U4',41),N('U1',25))
    c.apart(d,'UART directions / ground separate',N('U4',40),N('U4',41),N('U4',0))
    for pin,mcupin in [('1',34),('2',24),('3',36),('4',35),('5',22)]:c.same(d,'TFT connector pin '+pin+' mapping',N('CON1',pin),N('U4',mcupin))
    c.same(d,'FFC ground',N('CON1',6),N('CON1','MP'),N('U4',0));c.same(d,'FFC 3V3',N('CON1',7),N('U2',6));c.same(d,'FFC switched 5V',N('CON1',8),N('U6',6))

def extend_electrical(c,d,main=None):
    N=lambda ref,no:(ref,str(no))
    c.same(d,'Display FFC 5V / panel LED anode / driver BIAS',N('CON1',1),N('LCD1',3),N('U1',2))
    c.same(d,'Display FFC 3V3 / panel logic',N('CON1',2),N('LCD1',4))
    c.same(d,'Display FFC ground / mounting pads',N('CON1',3),N('CON1','MP'),N('LCD1',1),N('U1',4))
    c.apart(d,'Display 5V / 3V3 / GND separated',N('CON1',1),N('CON1',2),N('CON1',3))
    c.same(d,'Panel cathode only through AL5802 OUT',N('LCD1',2),N('U1',1))
    c.add('Panel cathode has only panel and current-sink nodes',d.nodes('LCD1',2)=={N('LCD1',2),N('U1',1)},sorted(d.nodes('LCD1',2)))
    c.apart(d,'Panel cathode / anode / GND separate',N('LCD1',2),N('LCD1',3),N('CON1',3))
    c.same(d,'AL5802 FB / REXT / current-sense resistor',N('U1',5),N('U1',6),N('R2',1))
    c.same(d,'AL5802 sense resistor grounded',N('R2',2),N('U1',4));c.value(d,'R2','27')
    c.apart(d,'Backlight sense / cathode / GND / BIAS separate',N('U1',5),N('U1',1),N('U1',4),N('U1',2))
    c.same(d,'AL5802 EN shunted by NMOS drain',N('U1',3),N('Q1',3))
    c.add('AL5802 EN has only driver and NMOS drain nodes',d.nodes('U1',3)=={N('U1',3),N('Q1',3)},sorted(d.nodes('U1',3)))
    c.same(d,'Backlight NMOS source grounded',N('Q1',2),N('CON1',3))
    c.same(d,'Backlight NMOS gate / series resistor / default-off pull-up',N('Q1',1),N('R1',2),N('R3',2))
    c.same(d,'Backlight GPIO through gate resistor',N('CON1',8),N('R1',1));c.same(d,'Backlight default-off pull-up to 3V3',N('R3',1),N('CON1',2))
    c.apart(d,'GPIO / NMOS gate / EN / GND / 3V3 separate',N('CON1',8),N('Q1',1),N('U1',3),N('CON1',3),N('CON1',2))
    c.value(d,'R1','1k');c.value(d,'R3','100k');c.value(d,'Q1','AO3400A')
    for ref,rail,expected in [('C1',2,'100nF'),('C2',2,'4.7uF'),('C3',1,'100nF'),('C4',1,'1uF')]:
        c.same(d,'Display '+ref+' supply',N(ref,1),N('CON1',rail));c.same(d,'Display '+ref+' ground',N(ref,2),N('CON1',3));c.value(d,ref,expected)
    c.add('Display 5V bypass selected 25V MPN',d.mpns.get('C4')=='GRM188R71E105KA12D',d.mpns.get('C4'))
    for lcdpin,ffc in [(7,4),(9,5),(10,6),(11,7)]:c.same(d,'Display SPI LCD pin '+str(lcdpin),N('LCD1',lcdpin),N('CON1',ffc))
    c.same(d,'Panel CS permanently selected',N('LCD1',8),N('CON1',3))
    if main is not None:
        # This checks connector logical assignments assuming pin i mates with
        # pin 9-i. Cable continuity/polarity still requires physical inspection.
        pairs=[(1,8,('U4','34'),N('R1',1),'GPIO5 / active-low backlight'),(2,7,('U4','24'),N('LCD1',11),'GPIO4 / panel reset'),(3,6,('U4','36'),N('LCD1',10),'GPIO23 / MOSI'),(4,5,('U4','35'),N('LCD1',9),'GPIO18 / SCK'),(5,4,('U4','22'),N('LCD1',7),'GPIO2 / DC'),(6,3,('U4','0'),N('U1',4),'GND'),(7,2,('U2','6'),N('LCD1',4),'3V3'),(8,1,('U6','6'),N('U1',2),'switched 5V')]
        for mp,ep,mnode,enode,label in pairs:
            ok=main.net('CON1',mp)==main.net(*mnode) and d.net('CON1',ep)==d.net(*enode) and main.net(*mnode) is not None and d.net(*enode) is not None
            c.add('FFC reverse mapping '+label,ok,{'assumption':'main pin i mates with display pin 9-i','main_pin':mp,'display_pin':ep,'main_net':main.net('CON1',mp),'display_net':d.net('CON1',ep)})

# Conservative axis-aligned bounds after rotation; useful for rejecting paste
# apertures/via barrels inside the die-pad window. Native DRC is still required.
def to_global(fp,x,y):
    at=get(fp,'at');a=math.radians(float(at[3]) if len(at)>3 else 0)
    # Native PCB pad coordinates already contain a footprint's B-side flip.
    # Apply only its rotation/translation; a second mirror moves real terminals.
    return (float(at[1])+x*math.cos(a)+y*math.sin(a),float(at[2])-x*math.sin(a)+y*math.cos(a))
def in_poly(p,poly):
    x,y=p;inside=False
    for i,(x1,y1) in enumerate(poly):
        x2,y2=poly[(i+1)%len(poly)]
        if min(x1,x2)-1e-7<=x<=max(x1,x2)+1e-7 and min(y1,y2)-1e-7<=y<=max(y1,y2)+1e-7 and abs((x-x1)*(y2-y1)-(y-y1)*(x2-x1))<1e-7:return True
        if (y1>y)!=(y2>y) and x<(x2-x1)*(y-y1)/(y2-y1)+x1:inside=not inside
    return inside

def mpu_geometry(c,board,fps):
    fp=fps.get('U3')
    if not c.add('MPU footprint present',fp is not None):return
    pads=alln(fp,'pad');nums={str(p[1]) for p in pads}
    c.add('MPU only pins 1–24; no unnamed/25 center pad',nums=={str(i) for i in range(1,25)},sorted(nums))
    # Actual original forbidden EP is 2.7 x 2.8 mm, centered in the package.
    corners=[to_global(fp,x,y) for x,y in [(-1.35,-1.4),(-1.35,1.4),(1.35,1.4),(1.35,-1.4)]]
    # Check center point + inner window for pads with paste; perimeter QFN
    # pads are outside this window. Pad margin uses actual pad dimensions.
    paste=[]
    for p in pads:
        layers=get(p,'layers',[])[1:]
        if not any(x in ['F.Paste','B.Paste','*.Paste'] for x in layers):continue
        at=get(p,'at');sz=get(p,'size');x,y=float(at[1]),float(at[2]);w,h=float(sz[1]),float(sz[2])
        a=math.radians((float(at[3]) if len(at)>3 else 0)-(float(get(fp,'at')[3]) if len(get(fp,'at'))>3 else 0))
        dx=(abs(w*math.cos(a))+abs(h*math.sin(a)))/2;dy=(abs(w*math.sin(a))+abs(h*math.cos(a)))/2
        if abs(x)<1.35+dx-1e-5 and abs(y)<1.4+dy-1e-5:paste.append(str(p[1]))
    c.add('No MPU paste aperture overlaps forbidden die window',not paste,paste)
    keep=[]
    for z in alln(board,'zone'):
        ko=get(z,'keepout');poly=get(z,'polygon');layers=get(z,'layers',get(z,'layer',[]))[1:]
        if not ko or not poly or get(fp,'layer')[1] not in layers:continue
        points=[(float(p[1]),float(p[2])) for p in alln(get(poly,'pts'),'xy')]
        if all(in_poly(p,points) for p in corners) and all(get(ko,k,[k,None])[1]=='not_allowed' for k in ['tracks','vias','pads','copperpour']):keep.append(str(get(z,'uuid')[1]))
    c.add('MPU die window covered by copper/track/via/pad keepout',bool(keep),keep)
    vias=[]
    for v in alln(board,'via'):
        at=get(v,'at');p=(float(at[1]),float(at[2]));radius=float(get(v,'size')[1])/2
        # Inflate via centers conservatively by barrel diameter bounds.
        cx,cy=to_global(fp,0,0)
        minx=min(p[0] for p in corners);maxx=max(p[0] for p in corners);miny=min(p[1] for p in corners);maxy=max(p[1] for p in corners)
        if minx-radius<p[0]<maxx+radius and miny-radius<p[1]<maxy+radius:vias.append(p)
    c.add('No through-via barrels in MPU die window',not vias,vias)

def pico_geometry(c,board,fps):
    """PICO thermal geometry is different from the MPU's forbidden die pad."""
    fp=fps.get('U4')
    if not c.add('PICO footprint present',fp is not None):return
    ep=next((p for p in alln(fp,'pad') if p[1]=='0'),None)
    if not c.add('PICO logical pad0 / physical49 thermal ground present',ep is not None):return
    size=get(ep,'size');layers=get(ep,'layers',[])[1:];net=get(ep,'net',[])
    c.add('PICO thermal copper 4.5mm square grounded',
          all(abs(float(x)-4.5)<.005 for x in size[1:3]) and net and net[-1]=='GND',
          {'size':size[1:3],'net':net})
    margin=get(ep,'solder_mask_margin',['solder_mask_margin','0'])
    c.add('PICO solder-mask-defined 4.0mm opening',
          'F.Mask' in layers and all(abs(float(x)+2*float(margin[1])-4.0)<.005 for x in size[1:3]),
          {'layers':layers,'local_mask_margin':margin[1]})
    c.add('PICO EP has no full-area paste aperture','F.Paste' not in layers and '*.Paste' not in layers,layers)
    windows=[]
    for p in alln(fp,'pad'):
        ls=get(p,'layers',[])[1:]
        if 'F.Paste' in ls and not any(x in ['F.Cu','B.Cu','*.Cu'] for x in ls):
            at=get(p,'at');sz=get(p,'size');windows.append((float(at[1]),float(at[2]),float(sz[1]),float(sz[2])))
    for shape in alln(fp,'fp_rect'):
        if get(shape,'layer',['layer',''])[1]!='F.Paste':continue
        start=get(shape,'start');end=get(shape,'end')
        if start and end:
            x1,y1=map(float,start[1:3]);x2,y2=map(float,end[1:3])
            windows.append(((x1+x2)/2,(y1+y2)/2,abs(x2-x1),abs(y2-y1)))
    expected=[(x,y) for x in [-1.575,-.525,.525,1.575] for y in [-1.575,-.525,.525,1.575]]
    c.add('PICO sixteen 0.75mm stencil windows / 0.30mm gaps',len(windows)==16 and all(
        any(abs(x-ex)<.005 and abs(y-ey)<.005 and abs(w-.75)<.005 and abs(h-.75)<.005
            for x,y,w,h in windows) for ex,ey in expected),windows)
    cx,cy=to_global(fp,0,0);a=math.radians(float(get(fp,'at')[3]) if len(get(fp,'at'))>3 else 0)
    thermal=[]
    for v in alln(board,'via'):
        at=get(v,'at');dx=float(at[1])-cx;dy=float(at[2])-cy
        x=dx*math.cos(a)-dy*math.sin(a);y=dx*math.sin(a)+dy*math.cos(a)
        if abs(x)<=2.26 and abs(y)<=2.26:
            thermal.append((x,y,float(get(v,'drill')[1]),float(get(v,'size')[1]),get(v,'net',['net',''])[-1]))
    grid=[(x,y) for x in [-2,-1.05,0,1.05,2] for y in [-2,-1.05,0,1.05,2]
          if not(abs(x)==2 and abs(y)==2)]
    c.add('PICO twenty-one 0.25mm ground thermal vias / >=0.10mm annulus',len(thermal)==21 and all(
        any(abs(x-ex)<.005 and abs(y-ey)<.005 and abs(d-.25)<.002 and (s-d)/2>=.0999 and n=='GND'
            for x,y,d,s,n in thermal) for ex,ey in grid),thermal)

def stack_geometry(c,board):
    """Check the actual inner-layer use, not just a plane's display name."""
    layers={str(n[1]) for n in get(board,'layers',[])[1:] if isinstance(n,list)}
    if 'In1.Cu' not in layers:return  # Original two-layer engineering source.
    copper=[str(n[1]) for n in get(board,'layers',[])[1:] if isinstance(n,list) and str(n[1]).endswith('.Cu')]
    c.add('Multilayer revision has reviewed copper layer order',copper in [
        ['F.Cu','In1.Cu','In2.Cu','B.Cu'],
        ['F.Cu','In1.Cu','In2.Cu','In3.Cu','In4.Cu','B.Cu']],copper)
    dedicated=[('In1.Cu','L2')]+([('In4.Cu','L5')] if 'In4.Cu' in layers else [])
    for layer,label in dedicated:
        foreign=[]
        for name in ['segment','arc']:
            for t in alln(board,name):
                if get(t,'layer',['layer',''])[1]==layer and get(t,'net',['net',''])[-1]!='GND':
                    foreign.append({'kind':name,'uuid':get(t,'uuid',['uuid',''])[1],'net':get(t,'net')})
        plane=[];bad=[]
        for z in alln(board,'zone'):
            if get(z,'keepout'):continue
            ls=get(z,'layers',get(z,'layer',[]))[1:]
            if layer not in ls:continue
            if get(z,'net',['net',''])[-1]=='GND':plane.append(z)
            else:bad.append(get(z,'net'))
        c.add('Dedicated '+label+' ground plane has no foreign tracks or pours',bool(plane) and not foreign and not bad,
              {'ground_planes':len(plane),'foreign_tracks':foreign,'foreign_pours':bad})
    stack=get(get(board,'setup',[]),'stackup',[])
    thicknesses=[float(get(n,'thickness')[1]) for n in alln(stack,'layer') if get(n,'thickness')]
    total=sum(thicknesses);model=float(get(get(board,'general'),'thickness')[1])
    c.add('Nominal stack thickness agrees with all copper/dielectric/mask layers',
          bool(thicknesses) and abs(total-model)<.00001,{'stack_sum_mm':total,'model_mm':model,'scope':'Nominal CAD bookkeeping; delivered stack/tolerance requires fabricator confirmation'})


def run_cli(cli,args):
    result=subprocess.run([str(cli),*map(str,args)],text=True,capture_output=True,env={**os.environ,'PYTHONDONTWRITEBYTECODE':'1'})
    return {'returncode':result.returncode,'stdout':result.stdout.strip(),'stderr':result.stderr.strip()}

def manufacturing_rules(c,project,stem):
    rules=project.get('board',{}).get('design_settings',{}).get('rules',{})
    try:
        web=float(rules.get('solder_mask_min_width'))
        clearance=float(rules.get('solder_mask_to_copper_clearance'))
        ok=web>=.10 and clearance>=.09
    except (TypeError,ValueError):
        ok=False
    c.add(stem+' manufacturing solder-mask rules',ok,
          {k:rules.get(k) for k in ['solder_mask_min_width','solder_mask_to_copper_clearance']})

def validate_board(cli,folder,stem,c,temp,drc=False):
    sch=folder/(stem+'.kicad_sch');pcb=folder/(stem+'.kicad_pcb');xml=temp/(stem+'.xml');erc=temp/(stem+'_erc.json')
    manufacturing_rules(c,json.loads((folder/(stem+'.kicad_pro')).read_text()),stem)
    export=run_cli(cli,['sch','export','netlist','--format','kicadxml','--output',xml,sch]);c.add(stem+' native netlist export',export['returncode']==0,export)
    if export['returncode']!=0:return None,None,None
    report=run_cli(cli,['sch','erc','--format','json','--severity-all','--exit-code-violations','--output',erc,sch]);ercdata=json.loads(erc.read_text()) if erc.exists() else {}
    violations=[v for s in ercdata.get('sheets',[]) for v in s.get('violations',[])]
    c.add(stem+' native ERC all severities',report['returncode']==0 and not violations,{'command':report,'violations':violations,'ignored_checks':ercdata.get('ignored_checks')})
    sc=schematic_netlist(xml);pd,tree,fps=pcb_circuit(pcb);parity(c,sc,pd,sch)
    if drc:
        out=temp/(stem+'_drc.json');r=run_cli(cli,['pcb','drc','--format','json','--all-track-errors','--schematic-parity','--refill-zones','--severity-all','--exit-code-violations','--output',out,pcb])
        data=json.loads(out.read_text()) if out.exists() else {}
        parity_ran='Failed to fetch schematic netlist' not in r['stdout']+r['stderr']
        c.add(stem+' native DRC all errors/parity',r['returncode']==0 and parity_ran and all(
            data.get(key)==[] for key in ['violations','unconnected_items','schematic_parity']),
            {'command':r,'report':data})
    return sc,tree,fps

def main():
    ap=argparse.ArgumentParser(description=__doc__);ap.add_argument('--root',type=Path,default=ROOT);ap.add_argument('--cli',type=Path,default=DEFAULT_CLI);ap.add_argument('--main-only',action='store_true');ap.add_argument('--drc',action='store_true');ap.add_argument('--output',type=Path,required=True);args=ap.parse_args()
    c=Checks();base=args.root/'1.Hardware/RevB-KiCad/Naive'
    if not args.cli.exists():ap.error('KiCad CLI not found: '+str(args.cli))
    with tempfile.TemporaryDirectory(prefix='holocubic-verify-') as td:
        temp=Path(td);sc,board,fps=validate_board(args.cli,base/'MainBoard','MainBoard',c,temp,args.drc)
        if sc is not None:main_electrical(c,sc);mpu_geometry(c,board,fps);pico_geometry(c,board,fps);stack_geometry(c,board)
        if not args.main_only:
            extdir=base/'ExtendBoard';c.add('Extension board native sources available',all((extdir/('ExtendBoard'+s)).exists() for s in ['.kicad_sch','.kicad_pcb']))
            if all((extdir/('ExtendBoard'+s)).exists() for s in ['.kicad_sch','.kicad_pcb']):
                ext,_,_=validate_board(args.cli,extdir,'ExtendBoard',c,temp,args.drc)
                if ext is not None:extend_electrical(c,ext,sc)
    result={'scope':'Static native KiCad sources; no physical behavior is measured.','main_only':args.main_only,'checks':c.rows,'passed':all(r['passed'] for r in c.rows)}
    args.output.parent.mkdir(parents=True,exist_ok=True);args.output.write_text(json.dumps(result,indent=2,ensure_ascii=False)+'\n')
    failed=[r['check'] for r in c.rows if not r['passed']];print('%d checks; %d failed. %s'%(len(c.rows),len(failed),args.output))
    for f in failed:print('FAIL '+f)
    raise SystemExit(1 if failed else 0)
if __name__=='__main__':main()
