guido233/HoloCubic/(commit log)

2026-10-29 Modernize ESP32 firmware and migrate the UI to LVGL 9
2026-10-29 Revise Naive hardware with routed KiCad boards and traceable BOM
    [BOM-grouped.csv, BOM.csv, BOM.xlsx, CA-C03_MaxBody_Bounding_Envelope.step, Diodes_SOT23_MaxBody_Bounding_Envelope.step, ESP32-PICO-D4_MaxBody_Bounding_Envelope.step, ExtendBoard.kicad_pcb, ExtendBoard.kicad_sch]
2026-10-30 Resolve Naive display landing and fabrication rules; add bring-up tools
    [BOM-grouped.csv, BOM.csv, BOM.xlsx, ExtendBoard.kicad_pcb, ExtendBoard.kicad_sch, Lower-RevB.step, MainBoard.kicad_pcb, measurement-record.csv]
2026-10-30 Use compatible small-quantity parts in Naive RevB
    [BOM-grouped.csv, BOM.csv, BOM.xlsx, ExtendBoard.kicad_pcb, ExtendBoard.kicad_sch, MainBoard.kicad_pcb, MainBoard.kicad_sch, measurement-record.csv]
